umn-impish/kicad/README.md

# kicad files for the IMPISH piggyback

## BEFORE COMMITTING
- **REMOVE ANY BIG FILES (.ZIP, .STEP GENERATED FROM BOARD, ETC)**
    - Keeps clone times fast and repo size small

## HOW TO OPEN
- Install Kicad
- Open the project file
- ...
