umn-impish/kicad/analog-mezzanine/parts/5v regulators/TPS7A4901DGNT.step

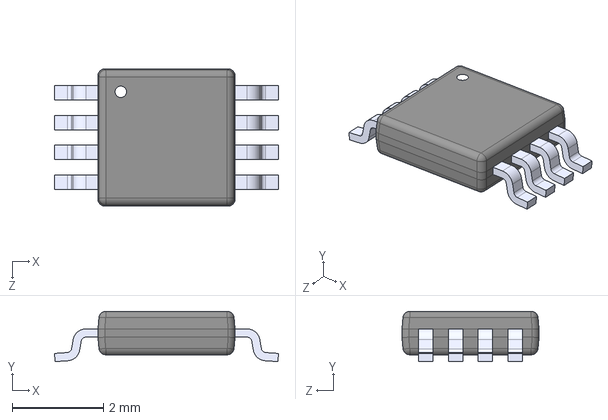
[picture p1: CAD file, 2025-06-12]
analog-mezzanine/parts/5v regulators/TPS7A4901DGNT.step
4.90 x 1.10 x 3.00 mm
