umn-impish/kicad/analog-mezzanine/parts/lowpass inductor/vls4015cx-h.step

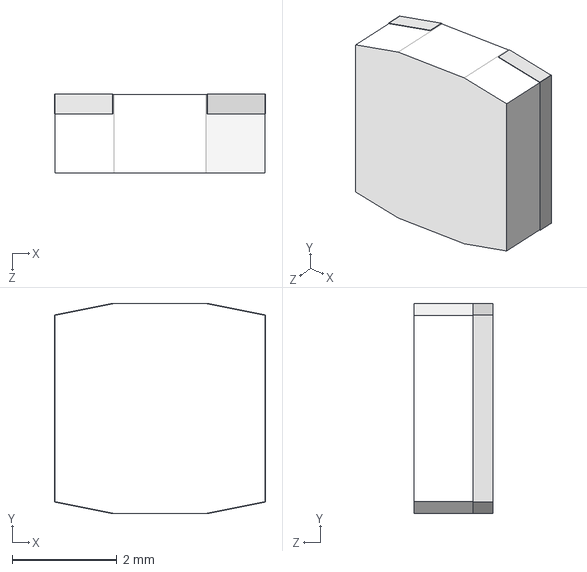
[picture p2: CAD file, 2025-06-12]
analog-mezzanine/parts/lowpass inductor/vls4015cx-h.step
4.02 x 4.01 x 1.50 mm
