umn-impish/kicad/bias-supply/components/42TM026-RC/42TM026-RC.stp

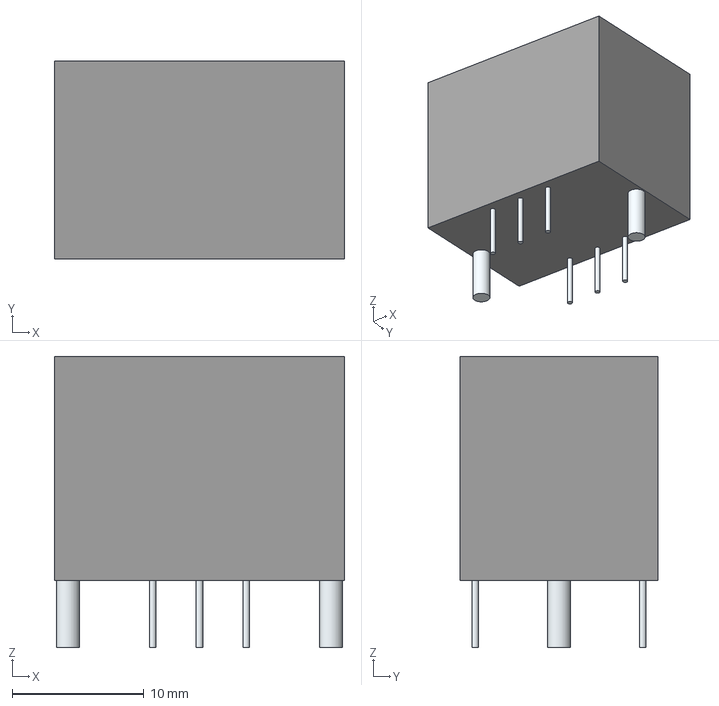
[picture p3: CAD file, 2024-10-08]
bias-supply/components/42TM026-RC/42TM026-RC.stp
22.0 x 15.0 x 22.1 mm
Leads
