umn-impish/kicad/bias-supply/components/AD5272BRMZ_20_RL7/AD5272BRMZ_20_RL7.stp

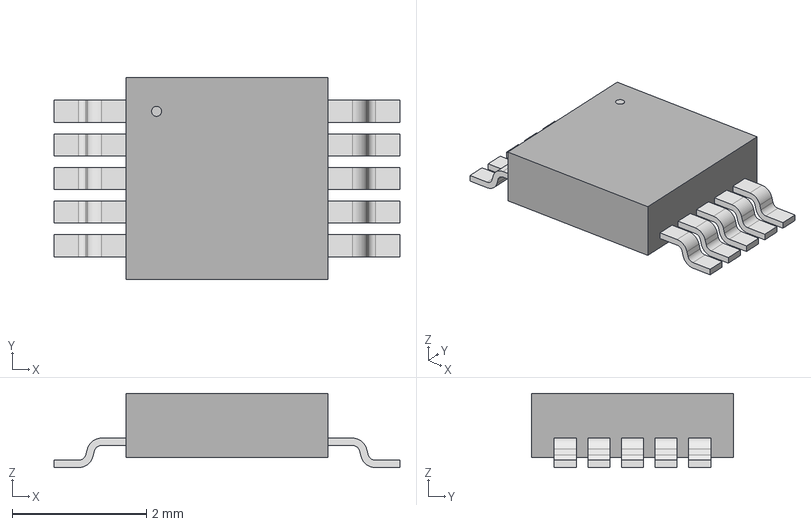
[picture p4: CAD file, 2025-06-12]
bias-supply/components/AD5272BRMZ_20_RL7/AD5272BRMZ_20_RL7.stp
5.15 x 3.00 x 1.10 mm
