umn-impish/kicad/bias-supply/components/AD5292BRUZ_100_RL7/AD5292BRUZ_100_RL7.stp

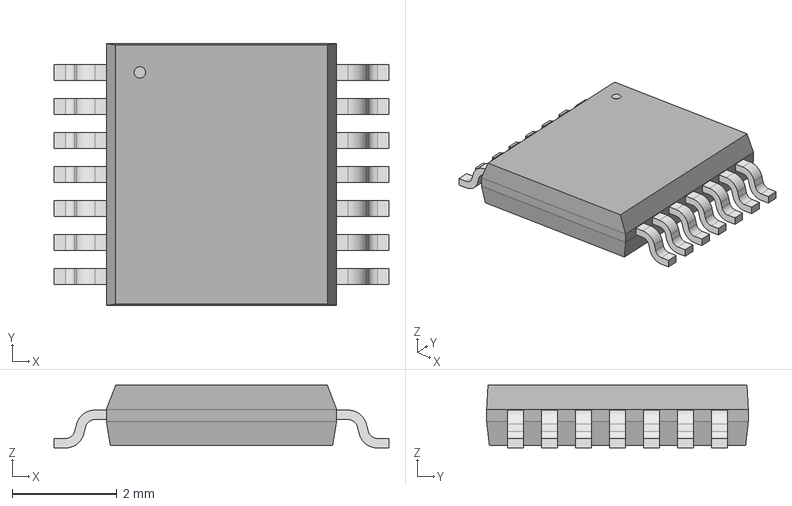
[picture p5: CAD file, 2025-06-12]
bias-supply/components/AD5292BRUZ_100_RL7/AD5292BRUZ_100_RL7.stp
6.40 x 5.00 x 1.20 mm
