umn-impish/kicad/bias-supply/components/ADP7142ARDZ-R7/SOIC8_ADP7142ARDZ-R7_ADI.step

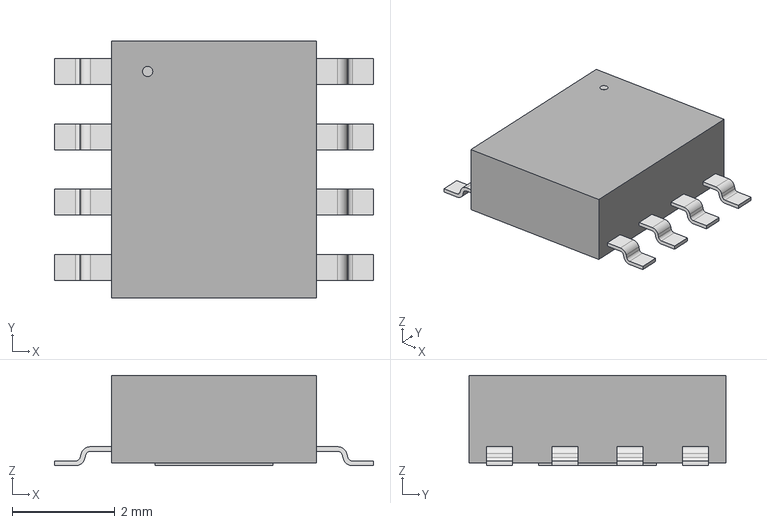
[picture p6: CAD file, 2024-10-08]
bias-supply/components/ADP7142ARDZ-R7/SOIC8_ADP7142ARDZ-R7_ADI.step
6.20 x 5.00 x 1.75 mm
