umn-impish/kicad/bias-supply/components/ADUM1253ASA/ADUM1253ASA.stp

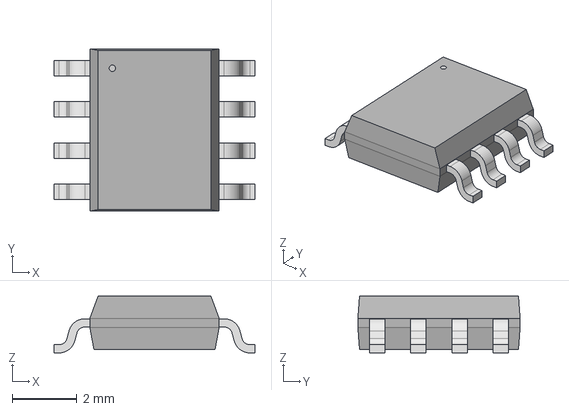
[picture p7: CAD file, 2025-06-12]
bias-supply/components/ADUM1253ASA/ADUM1253ASA.stp
6.20 x 5.00 x 1.75 mm
