umn-impish/kicad/bias-supply/components/BNX022_01L/BNX022-01L.stp

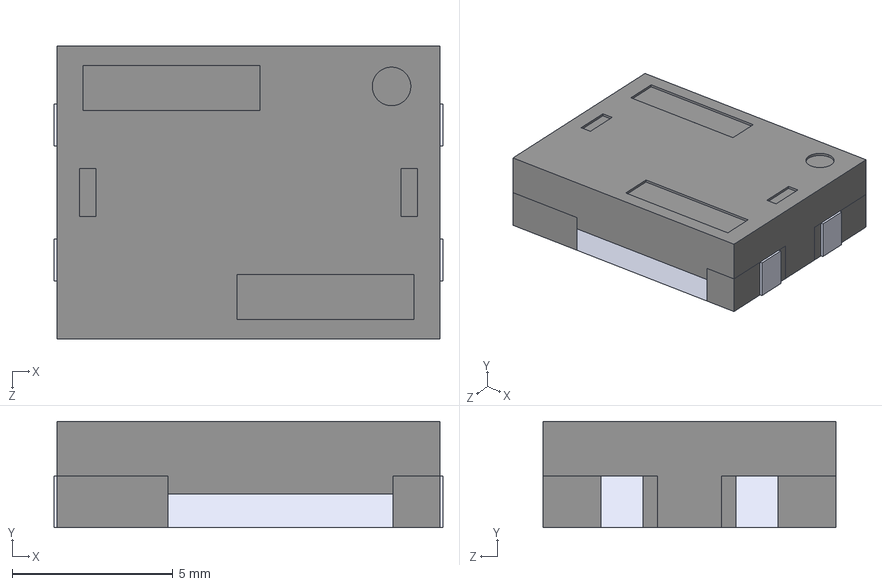
[picture p8: CAD file, 2024-10-08]
bias-supply/components/BNX022_01L/BNX022-01L.stp
12.1 x 3.30 x 9.10 mm
