umn-impish/kicad/bias-supply/components/DTDG14GPT100/DTDG14GPT100.stp

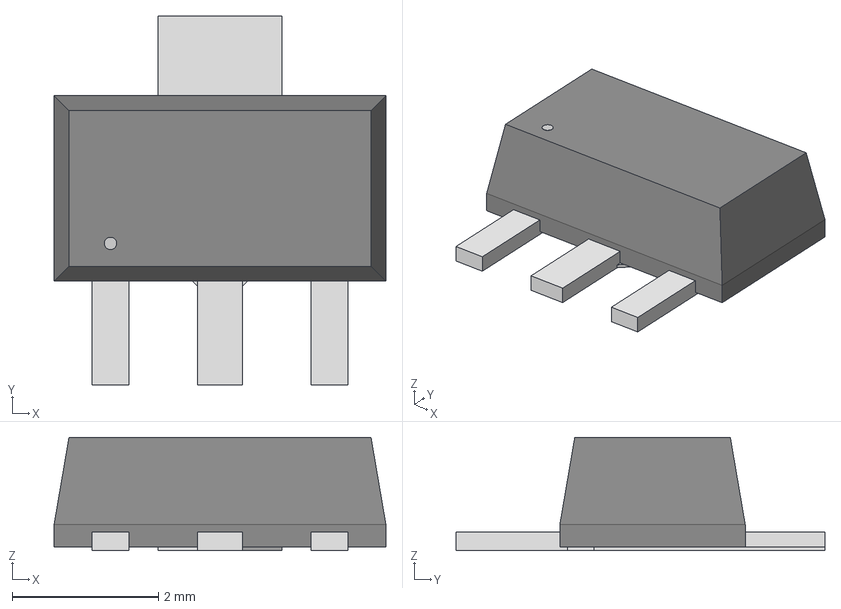
[picture p9: CAD file, 2024-10-08]
bias-supply/components/DTDG14GPT100/DTDG14GPT100.stp
4.55 x 5.05 x 1.55 mm
