umn-impish/kicad/bias-supply/components/F0603G0R02FNTR/F0603G0R02FNTR.stp

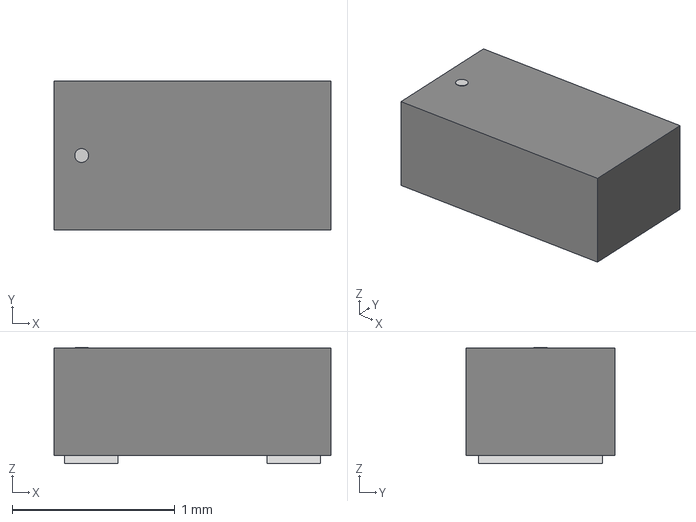
[picture p10: CAD file, 2026-04-10]
bias-supply/components/F0603G0R02FNTR/F0603G0R02FNTR.stp
1.70 x 0.914 x 0.714 mm
