umn-impish/kicad/bias-supply/components/KDZVTR36B/DIO_KDZLVTF100_ROM.step

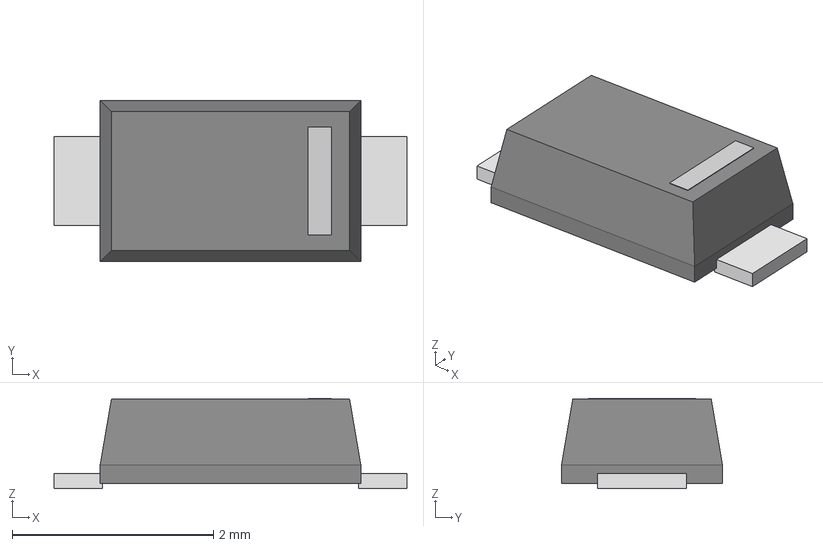
[picture p11: CAD file, 2024-10-08]
bias-supply/components/KDZVTR36B/DIO_KDZLVTF100_ROM.step
3.51 x 1.60 x 0.895 mm
