umn-impish/kicad/bias-supply/components/KMB22S/KMB22S.stp

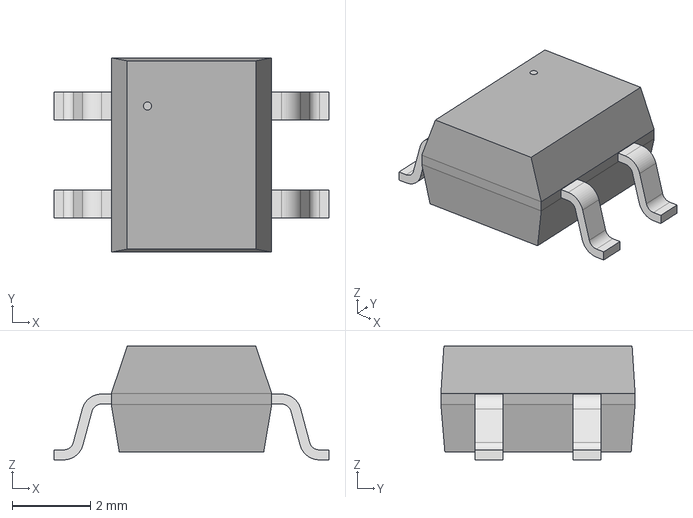
[picture p12: CAD file, 2024-10-08]
bias-supply/components/KMB22S/KMB22S.stp
7.01 x 4.95 x 2.90 mm
