umn-impish/kicad/bias-supply/components/LT3013MPFE_PBF/LT3013MPFE_PBF.stp

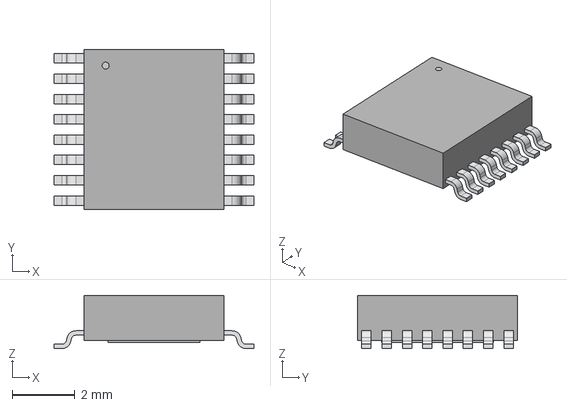
[picture p13: CAD file, 2025-06-12]
bias-supply/components/LT3013MPFE_PBF/LT3013MPFE_PBF.stp
6.40 x 5.11 x 1.70 mm
