umn-impish/kicad/bias-supply/components/MIC5281_3_3YMME_TR/MIC5281_3_3YMME_TR.stp

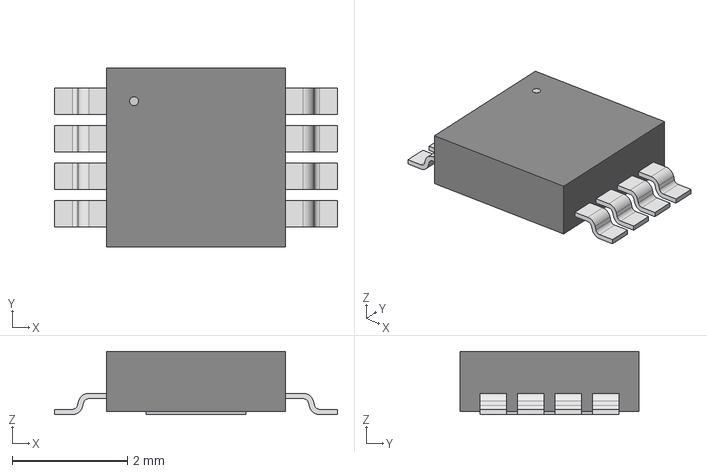
[picture p14: CAD file, 2025-06-12]
bias-supply/components/MIC5281_3_3YMME_TR/MIC5281_3_3YMME_TR.stp
4.90 x 3.10 x 1.09 mm
