umn-impish/kicad/bias-supply/components/MSD1278/MSD1278.stp

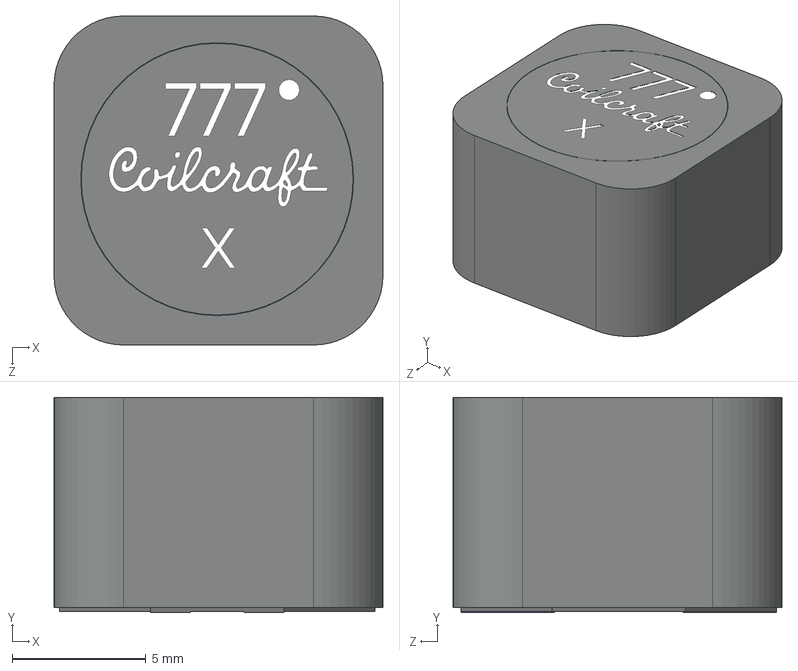
[picture p15: CAD file, 2024-10-08]
bias-supply/components/MSD1278/MSD1278.stp
12.3 x 8.05 x 12.3 mm
