umn-impish/kicad/bias-supply/components/Samtec-SMA/SMA-J-P-X-ST-TH1.stp

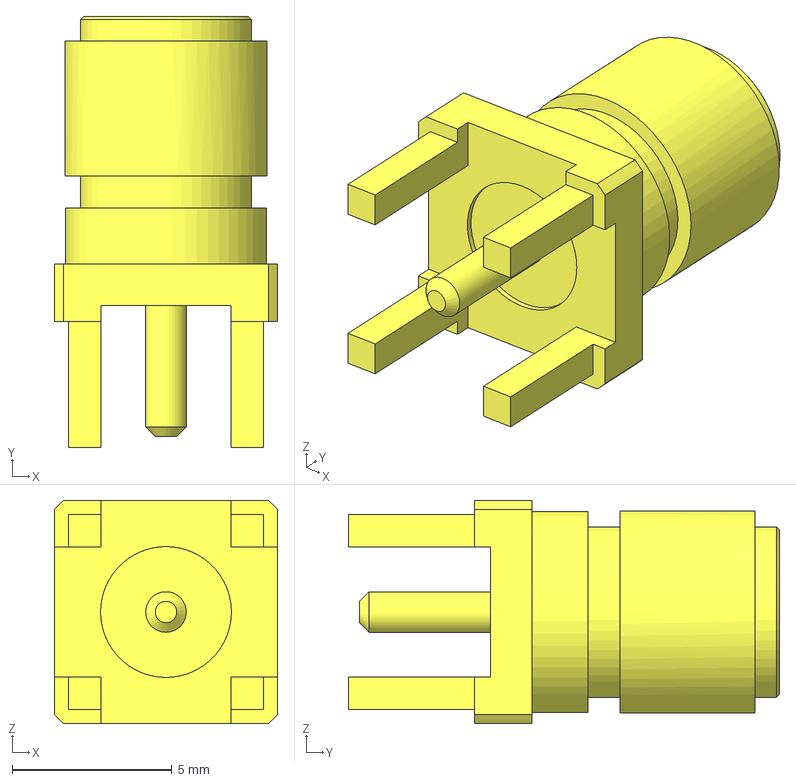
[picture p16: CAD file, 2024-10-08]
bias-supply/components/Samtec-SMA/SMA-J-P-X-ST-TH1.stp
7.00 x 13.5 x 7.00 mm
