umn-impish/kicad/bias-supply/components/TCA0372BDWR2G/TCA0372BDWR2G.stp

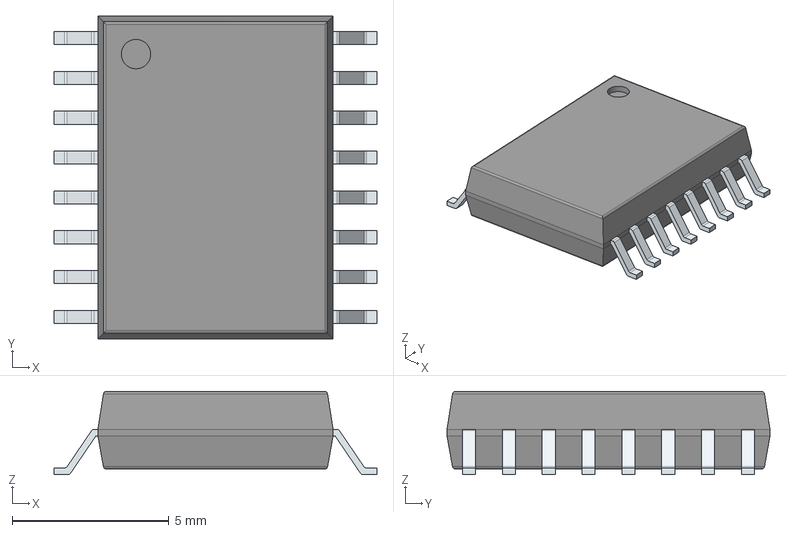
[picture p17: CAD file, 2024-10-08]
bias-supply/components/TCA0372BDWR2G/TCA0372BDWR2G.stp
10.3 x 10.3 x 2.65 mm
PinsArrayLR
