umn-impish/kicad/emmc-tester/emmc_100ball.step

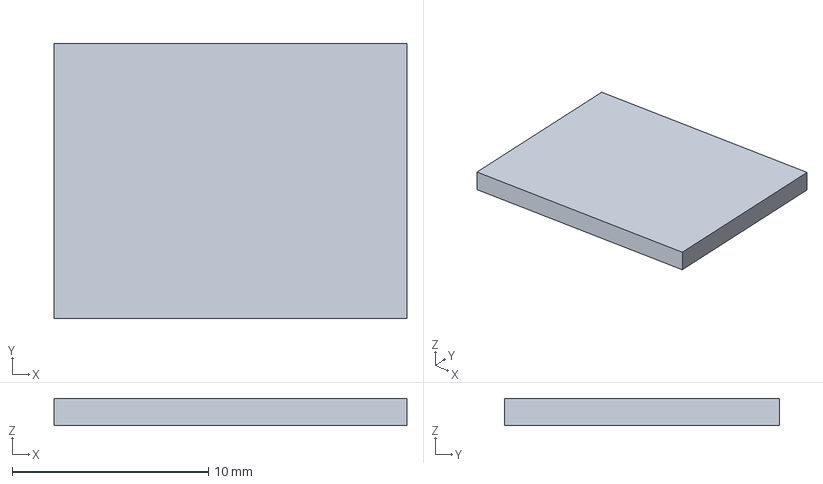
[picture p18: CAD file, 2025-07-15]
emmc-tester/emmc_100ball.step
18.0 x 14.0 x 1.40 mm
