umn-impish/kicad/lvps-swri/3D Models/T495X106K050ATE300.step

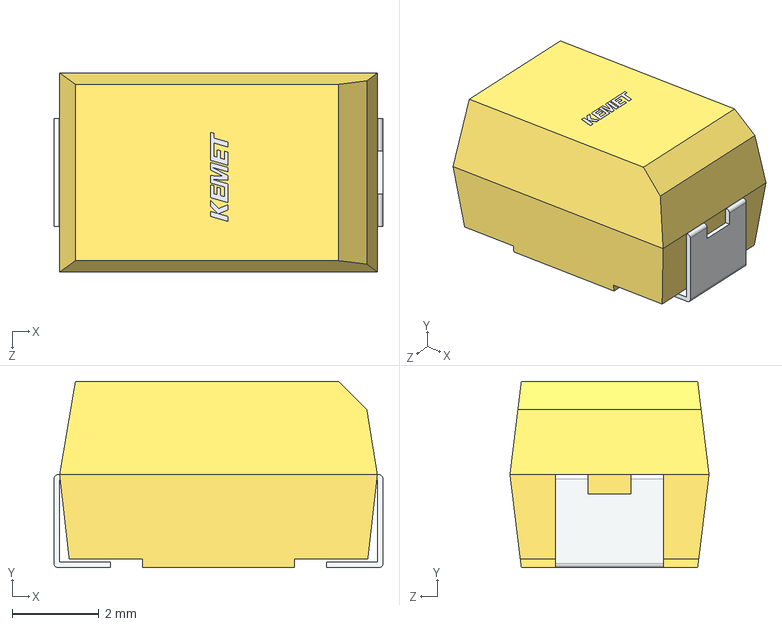
[picture p19: CAD file, 2025-06-26]
lvps-swri/3D Models/T495X106K050ATE300.step
7.60 x 4.31 x 4.60 mm
