umn-impish/kicad/lvps-toggles-adapter/lvps-toggles-adapter.step

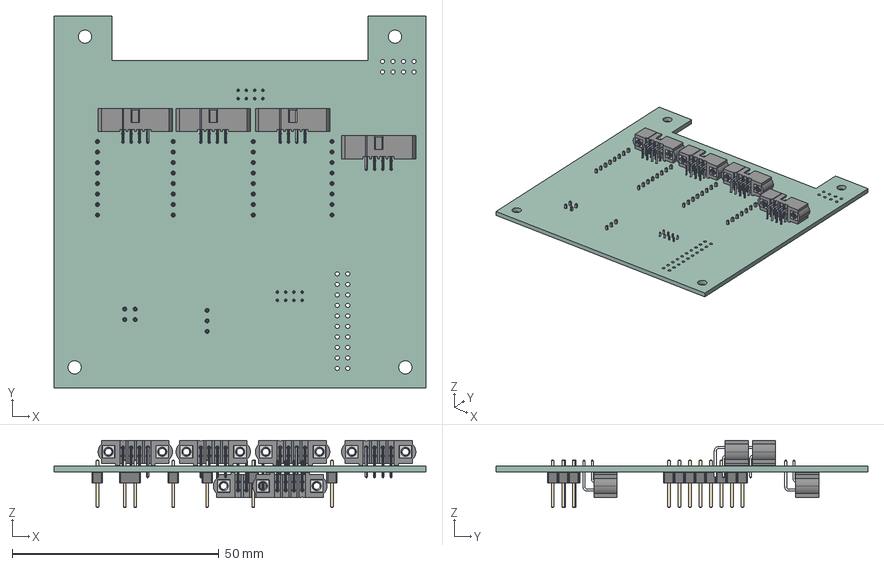
[picture p20: CAD file, 2025-09-08]
lvps-toggles-adapter/lvps-toggles-adapter.step
90.0 x 90.0 x 16.3 mm
PinHeader_1x08_P2.54mm_Vertical x 4
PinHeader_2x02_P2.54mm_Vertical
PinHeader_1x03_P2.54mm_Vertical
lvps-toggles-adapter_PCB
