umn-impish/kicad/lvps-toggles-adapter/parts/plastic ethernet/RJHSE50800104.step

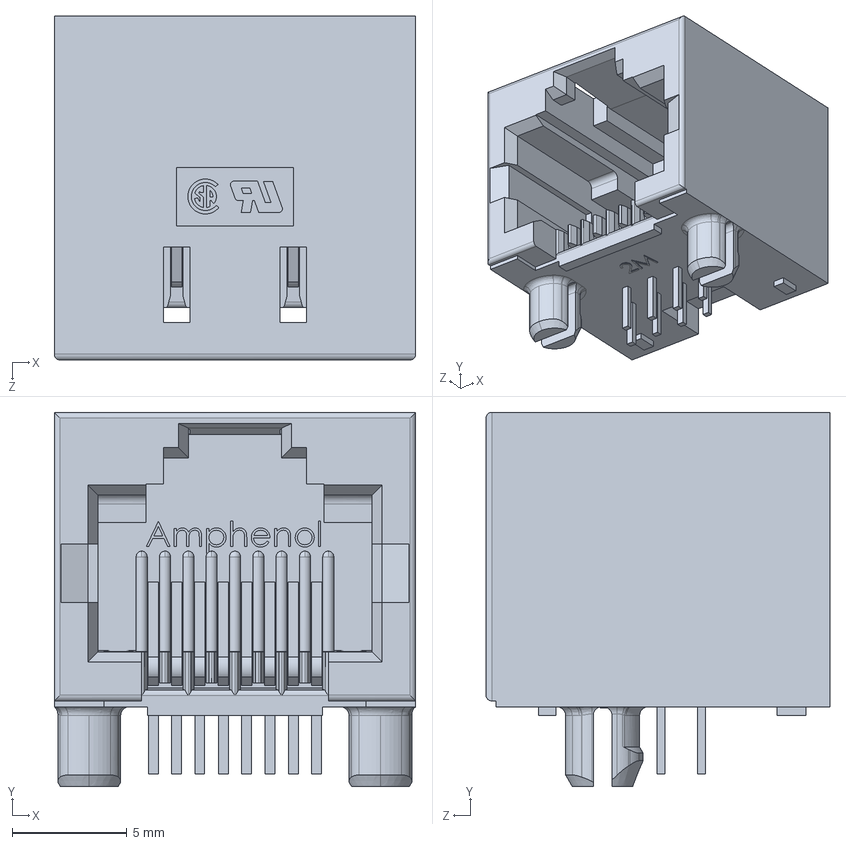
[picture p21: CAD file, 2025-09-08]
lvps-toggles-adapter/parts/plastic ethernet/RJHSE50800104.step
15.7 x 16.3 x 15.0 mm
