umn-impish/kicad/lvps-toggles-swri/3D Models/MTSW-117-10-L-D-070.stp

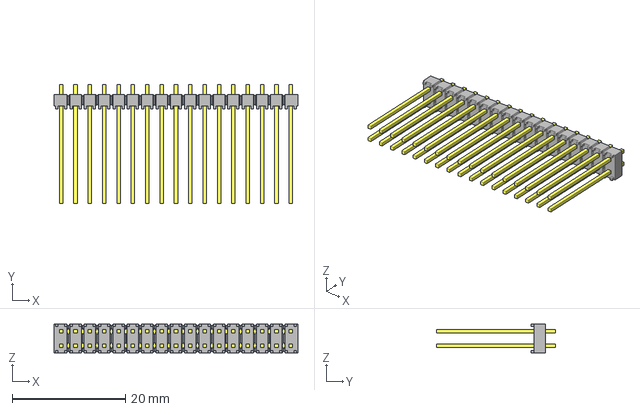
[picture p22: CAD file, 2025-09-08]
lvps-toggles-swri/3D Models/MTSW-117-10-L-D-070.stp
43.2 x 21.1 x 5.08 mm
MTSW-117-10-L-D-070_body
MTSW-117-10-D-070
