umn-impish/kicad/onsemi-double-coax-no-amp/coax/SMP-PF-P-HG-ST-TH2.step

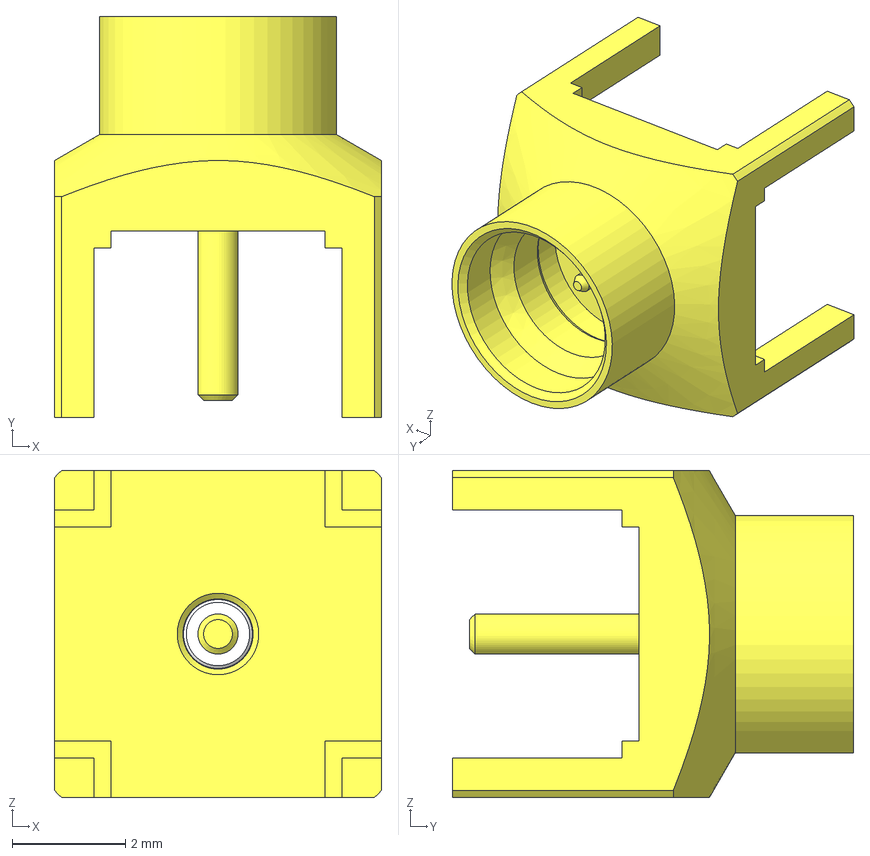
[picture p23: CAD file, 2024-10-10]
onsemi-double-coax-no-amp/coax/SMP-PF-P-HG-ST-TH2.step
5.78 x 7.09 x 5.78 mm
SMP-PF-P-HG-ST-TH2_p
SMP-PF-P-HG-ST-TH2_i
SMP-PF-P-HG-ST-TH2_s
