umn-impish/kicad/onsemi-double-coax-no-amp/DF13-3P-1.25DSA.stp

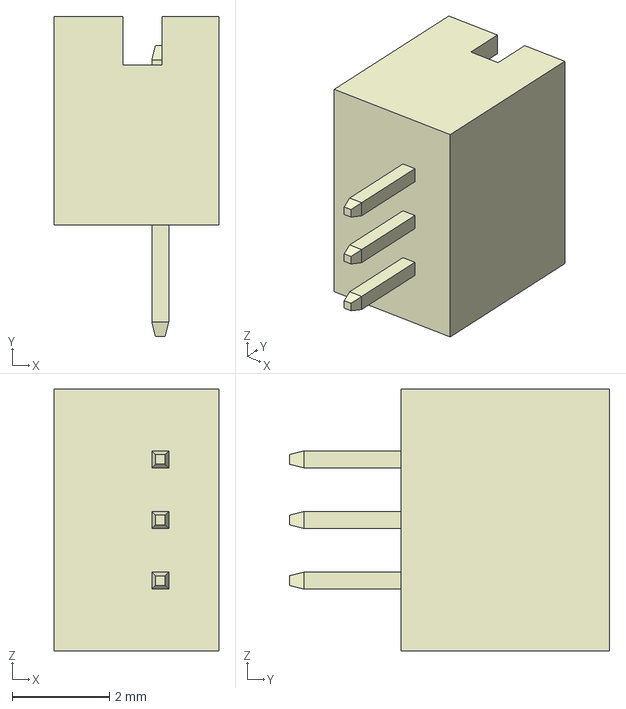
[picture p24: CAD file, 2024-10-10]
onsemi-double-coax-no-amp/DF13-3P-1.25DSA.stp
3.40 x 6.60 x 5.40 mm
