umn-impish/kicad/peak-holder/components/3214W_1_504E/3214W-1-504E.step

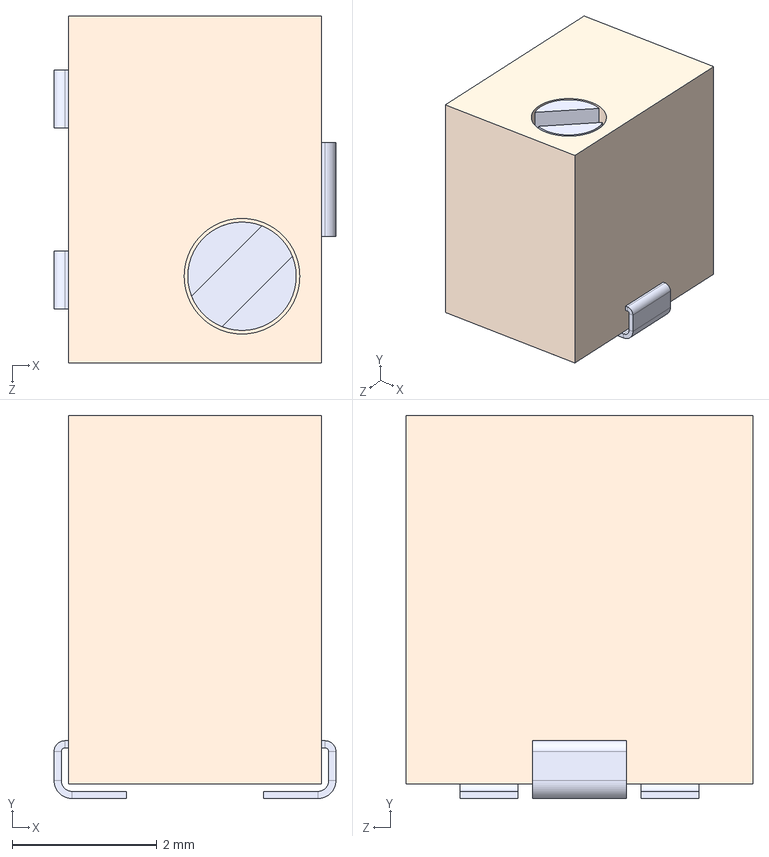
[picture p25: CAD file, 2024-10-10]
peak-holder/components/3214W_1_504E/3214W-1-504E.step
3.90 x 5.30 x 4.80 mm
