umn-impish/kicad/peak-holder/components/74LVCE1G04SE-7/74LVCE1G04SE-7.step

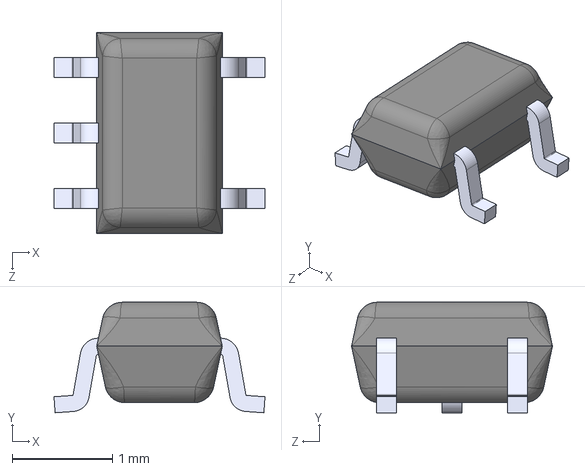
[picture p26: CAD file, 2024-10-10]
peak-holder/components/74LVCE1G04SE-7/74LVCE1G04SE-7.step
2.10 x 1.10 x 2.00 mm
