umn-impish/kicad/peak-holder/components/DS1100Z-20+/21-0041B_8_MXM.step

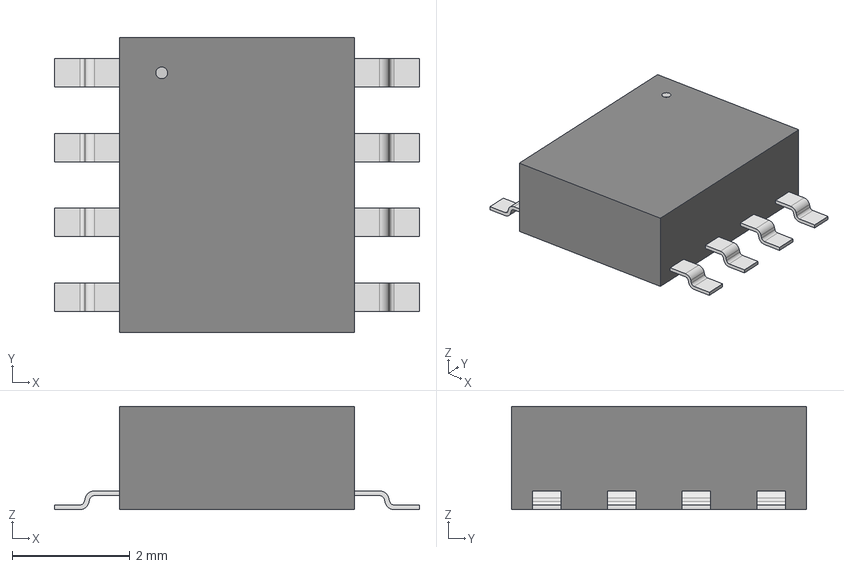
[picture p27: CAD file, 2024-10-10]
peak-holder/components/DS1100Z-20+/21-0041B_8_MXM.step
6.20 x 5.00 x 1.75 mm
