umn-impish/kicad/peak-holder/components/hold-cap/FKP2_04_5WX06_0HX07_2L_WIM.step

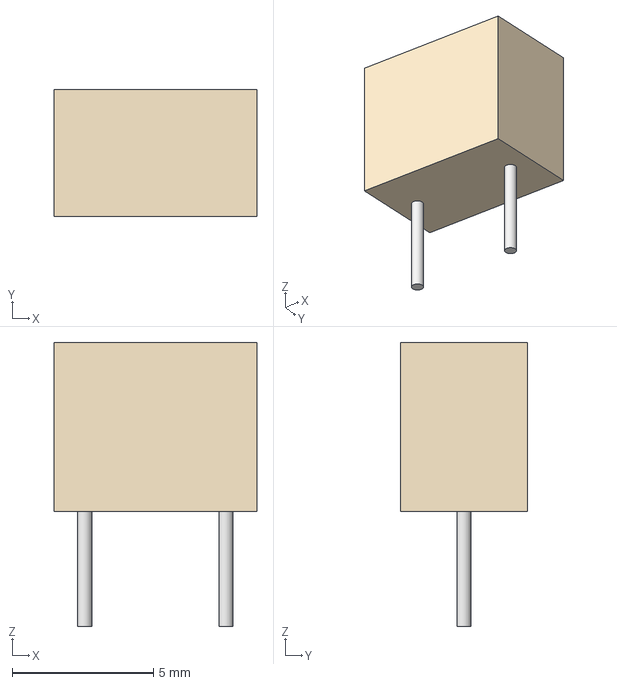
[picture p28: CAD file, 2024-10-10]
peak-holder/components/hold-cap/FKP2_04_5WX06_0HX07_2L_WIM.step
7.19 x 4.50 x 10.1 mm
