umn-impish/kicad/peak-holder/components/NC7ST04P5X/NC7ST04P5X.step

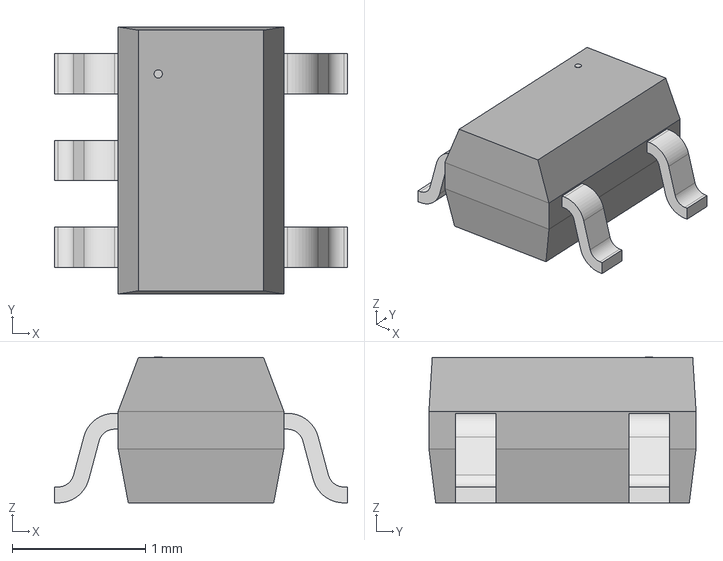
[picture p29: CAD file, 2024-10-10]
peak-holder/components/NC7ST04P5X/NC7ST04P5X.step
2.20 x 2.01 x 1.09 mm
