umn-impish/kicad/peak-holder/components/OPA615/DGS0010A.stp

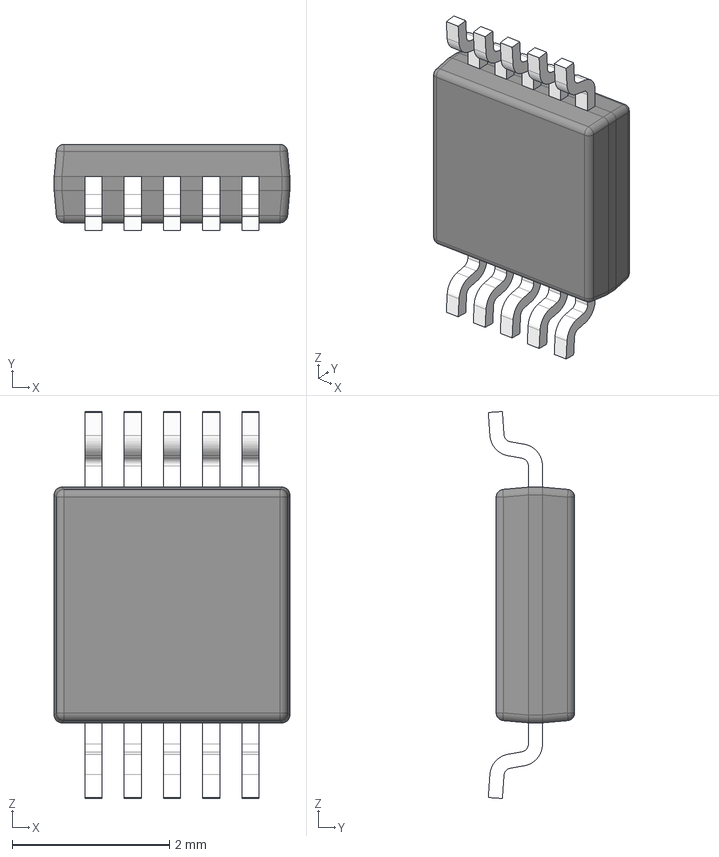
[picture p30: CAD file, 2024-10-08]
peak-holder/components/OPA615/DGS0010A.stp
3.00 x 1.10 x 4.93 mm
BODY-SO
LEAD-SO x 10
PIN1-ID
