umn-impish/kicad/peak-holder/components/PWB-1-BL/Coilcraft-PWB Series.STEP

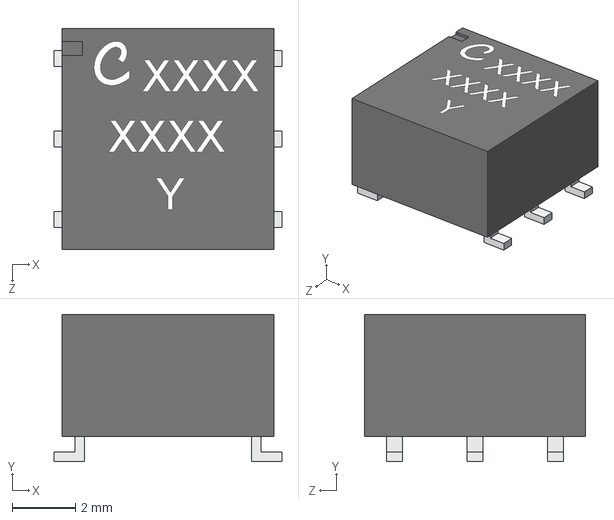
[picture p31: CAD file, 2024-10-10]
peak-holder/components/PWB-1-BL/Coilcraft-PWB Series.STEP
7.20 x 4.65 x 6.97 mm
