umn-impish/kicad/peak-holder/components/SN74LVC1G123DCUR/SN74LVC1G123DCUR.step

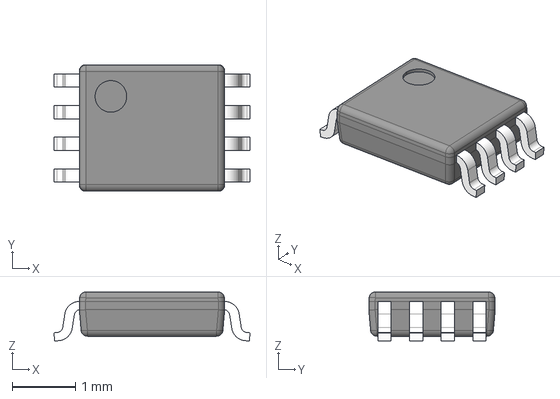
[picture p32: CAD file, 2024-10-10]
peak-holder/components/SN74LVC1G123DCUR/SN74LVC1G123DCUR.step
3.10 x 2.00 x 0.775 mm
BODY-VSSOP
LEAD-VSSOP x 8
