umn-impish/kicad/peak-holder/components/TLV3601DBVR/TLV3601.step

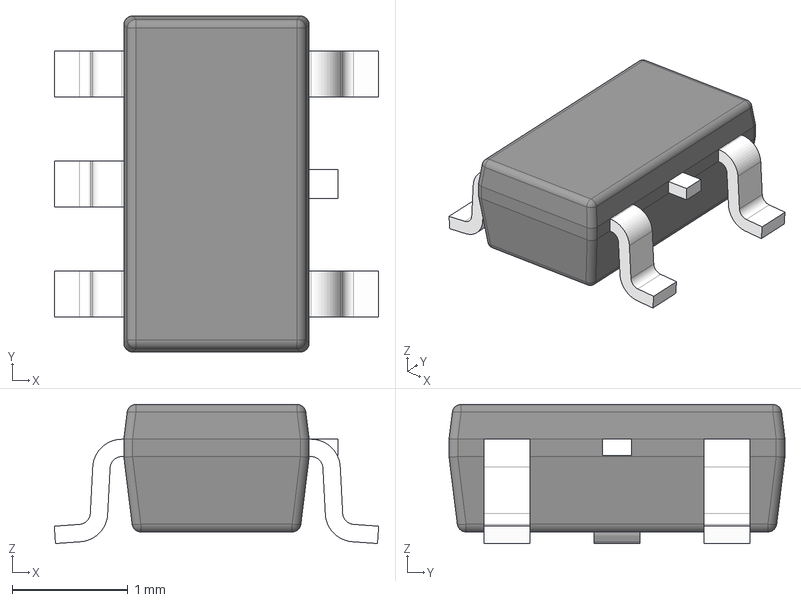
[picture p33: CAD file, 2024-10-10]
peak-holder/components/TLV3601DBVR/TLV3601.step
2.80 x 2.90 x 1.20 mm
BODY-SOT
LEAD-SOT x 5
LEAD-DUMMY
