umn-impish/kicad/sipm-carrier-flight/components/adp7185/CP-8-27_ADI.step

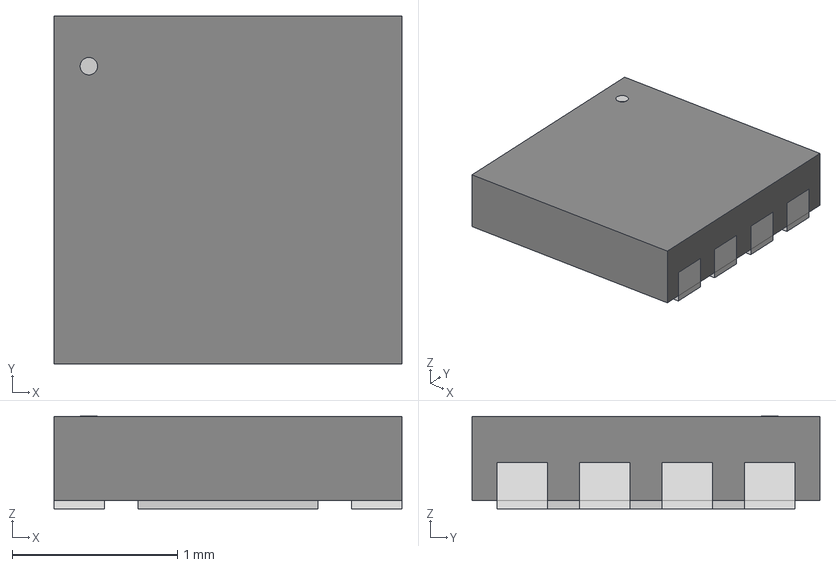
[picture p34: CAD file, 2024-10-10]
sipm-carrier-flight/components/adp7185/CP-8-27_ADI.step
2.11 x 2.11 x 0.561 mm
