umn-impish/kicad/sipm-carrier-flight/components/broadcom-sipms/AFBR-S4N66P014M.stp

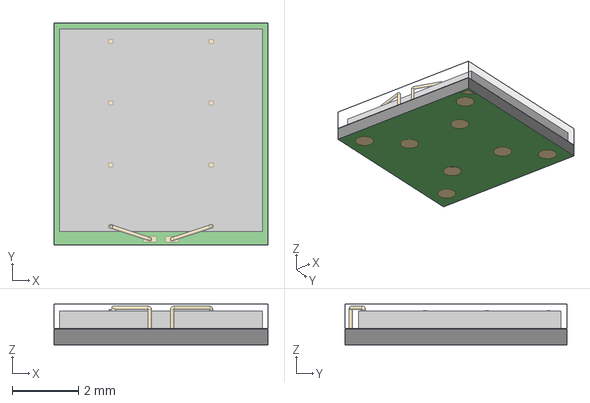
[picture p35: CAD file, 2025-04-07]
sipm-carrier-flight/components/broadcom-sipms/AFBR-S4N66P014M.stp
6.48 x 6.71 x 1.23 mm
