umn-impish/kicad/sipm-carrier-flight/components/BUF602/D0008A.stp

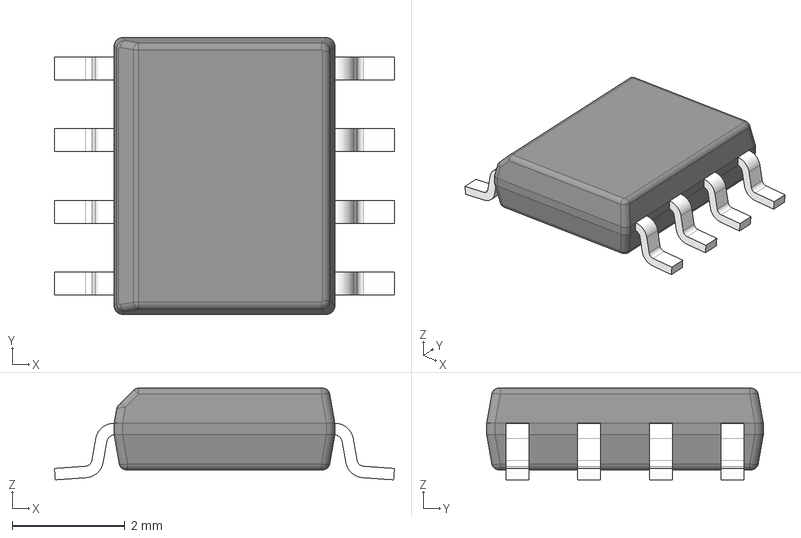
[picture p36: CAD file, 2024-10-10]
sipm-carrier-flight/components/BUF602/D0008A.stp
6.02 x 4.90 x 1.63 mm
BODY-SO
LEAD-D0008A x 8
