umn-impish/kicad/sipm-carrier-flight/components/CONSMA020.062-G/CONSMA020.062-G.step

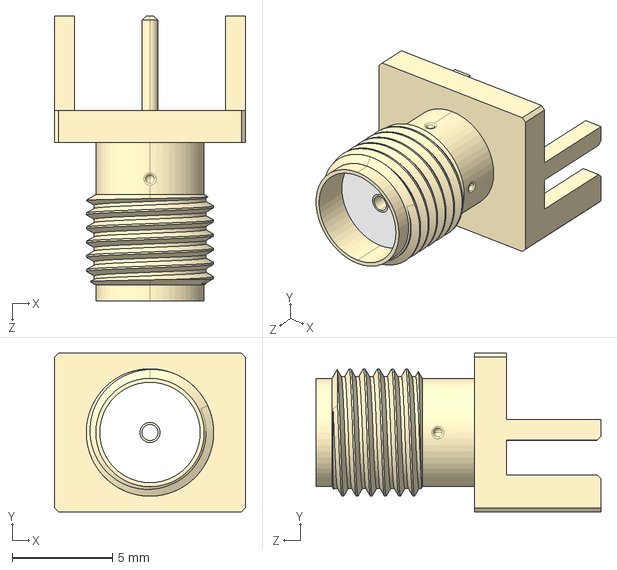
[picture p37: CAD file, 2024-10-24]
sipm-carrier-flight/components/CONSMA020.062-G/CONSMA020.062-G.step
9.52 x 7.92 x 14.2 mm
