umn-impish/kicad/sipm-carrier-flight/components/EMPCB.SMAFSTJ.B.HT/EMPCB.SMAFSTJ.B.HT.step

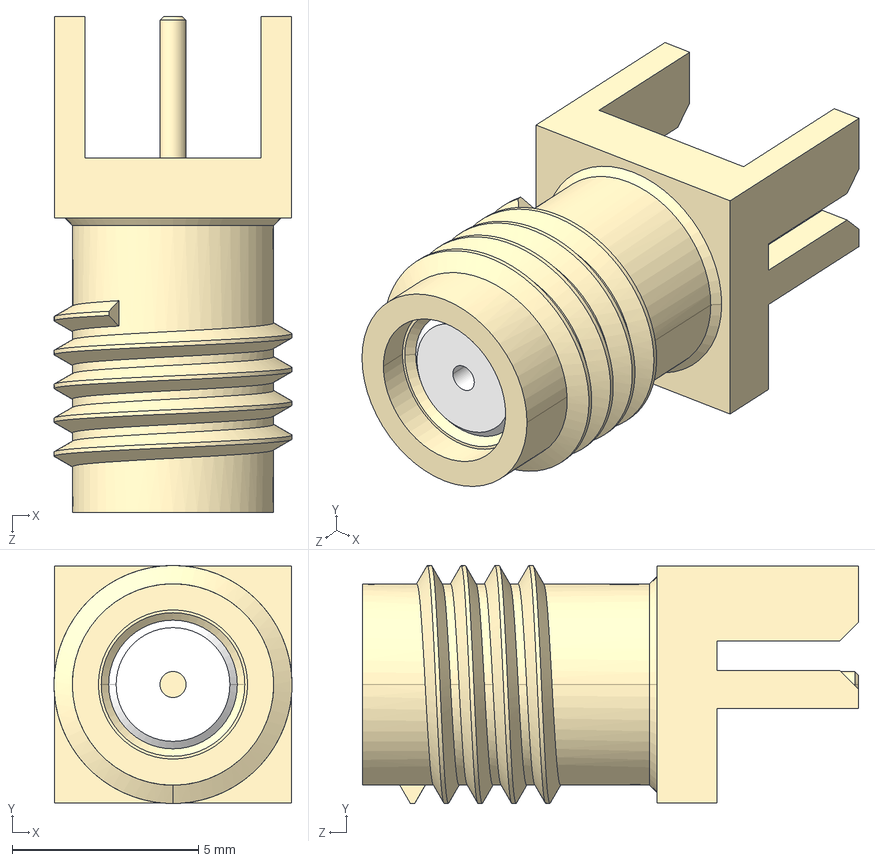
[picture p38: CAD file, 2024-10-10]
sipm-carrier-flight/components/EMPCB.SMAFSTJ.B.HT/EMPCB.SMAFSTJ.B.HT.step
6.38 x 6.38 x 13.3 mm
