umn-impish/kicad/sipm-carrier-flight/components/ltc6268/LTC6268HS8-10_PBF.step

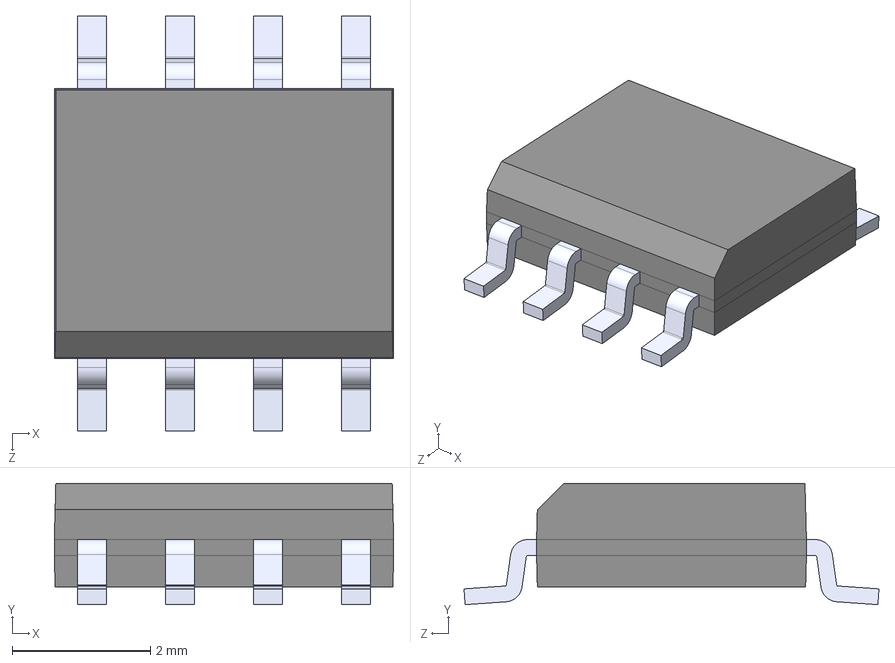
[picture p39: CAD file, 2024-10-10]
sipm-carrier-flight/components/ltc6268/LTC6268HS8-10_PBF.step
4.90 x 1.75 x 5.99 mm
