umn-impish/kicad/sipm-carrier-flight/components/onsemi-cseries-6mm2/MICROFC-60035-SMT-TR1.step

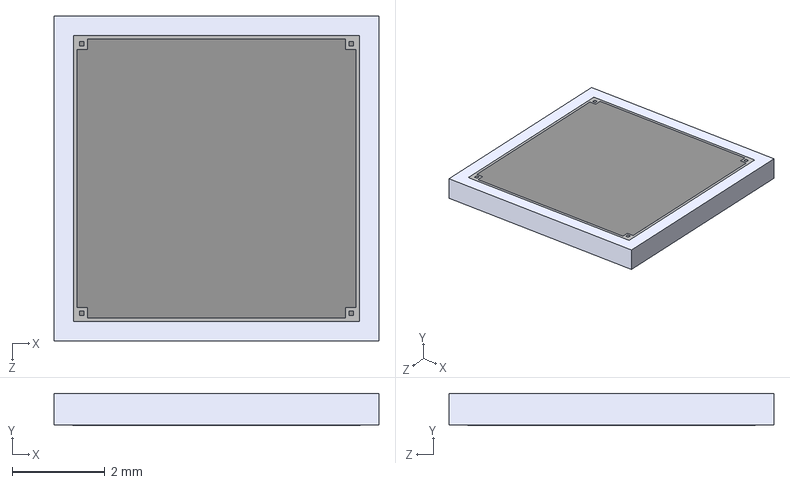
[picture p40: CAD file, 2024-10-10]
sipm-carrier-flight/components/onsemi-cseries-6mm2/MICROFC-60035-SMT-TR1.step
7.00 x 0.7 x 7.00 mm
