umn-impish/kicad/sipm-carrier-flight/components/three-winding choke/Download_STP_744253101_rev1.stp

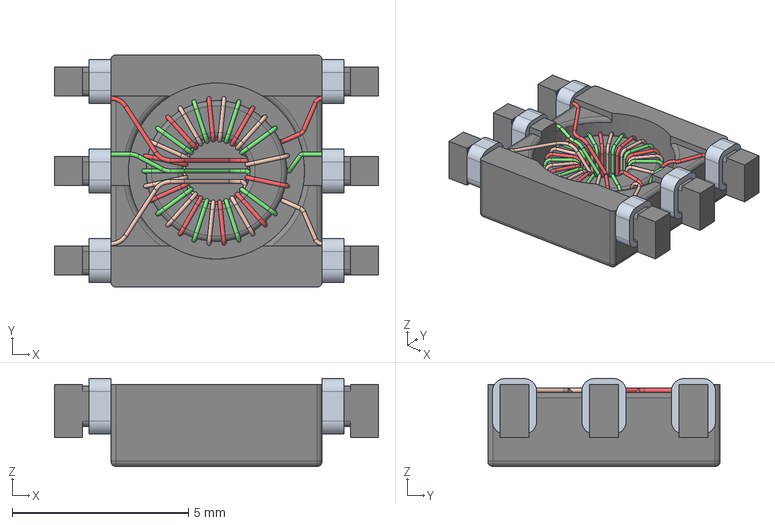
[picture p41: CAD file, 2025-06-12]
sipm-carrier-flight/components/three-winding choke/Download_STP_744253101_rev1.stp
9.20 x 6.60 x 2.50 mm
