umn-impish/kicad/sipm-carrier-flight/components/wurth-865080340001/WCAP-ASLI_4X5.5.step

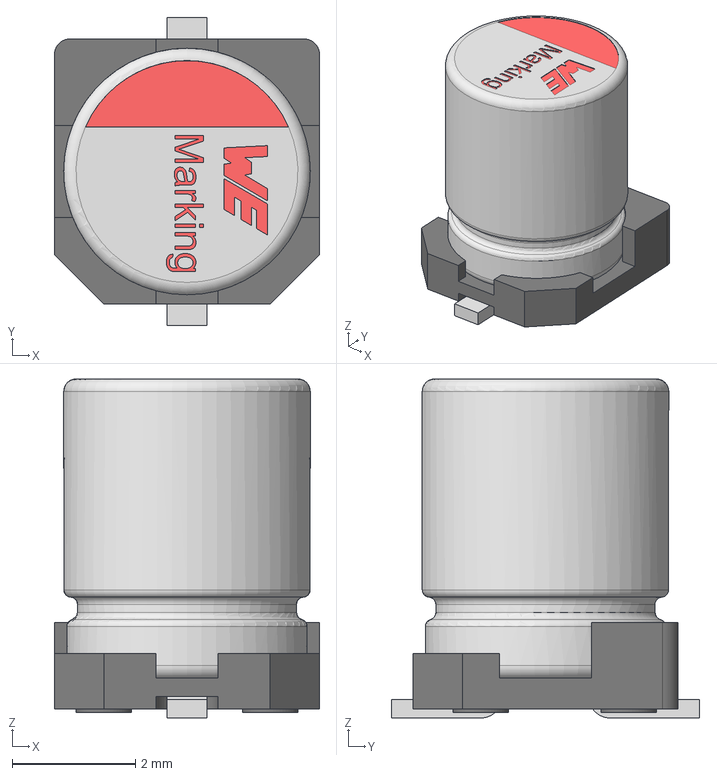
[picture p42: CAD file, 2024-10-10]
sipm-carrier-flight/components/wurth-865080340001/WCAP-ASLI_4X5.5.step
4.30 x 5.00 x 5.50 mm
capicitor_4x5.5x1
Base_Φ4Capacitor
