umn-impish/kicad/tia-csp-test-board/ad8001/R_8_ADI.step

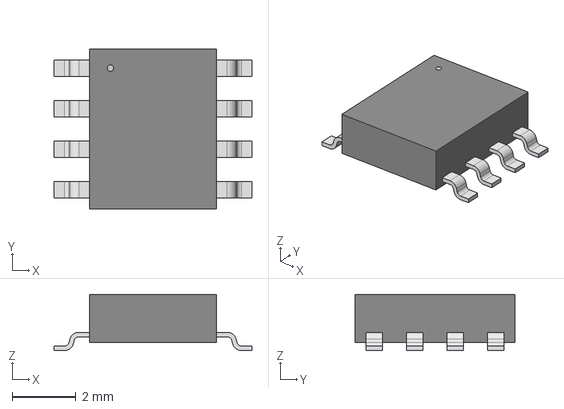
[picture p43: CAD file, 2024-10-10]
tia-csp-test-board/ad8001/R_8_ADI.step
6.20 x 5.00 x 1.75 mm
