umn-impish/kicad/tia-csp-test-board/lt1763/DFN-12_DE_LIT.step

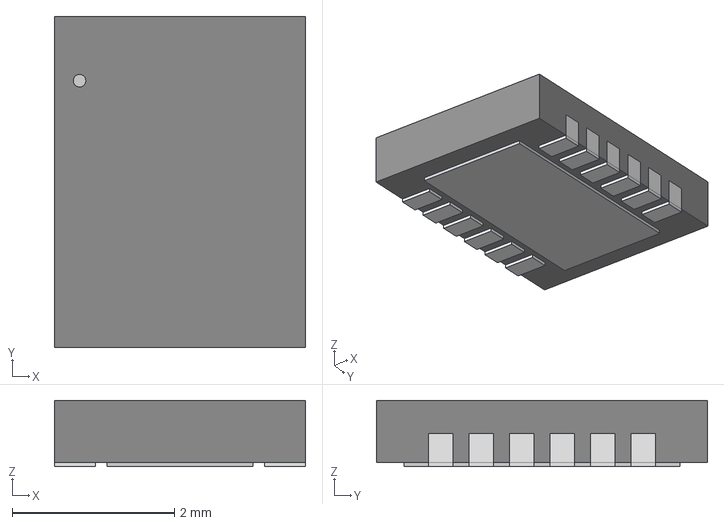
[picture p44: CAD file, 2024-10-10]
tia-csp-test-board/lt1763/DFN-12_DE_LIT.step
3.10 x 4.09 x 0.815 mm
