umn-impish/kicad/analog-mezzanine/parts/5v regulators/DGN0008D.stp

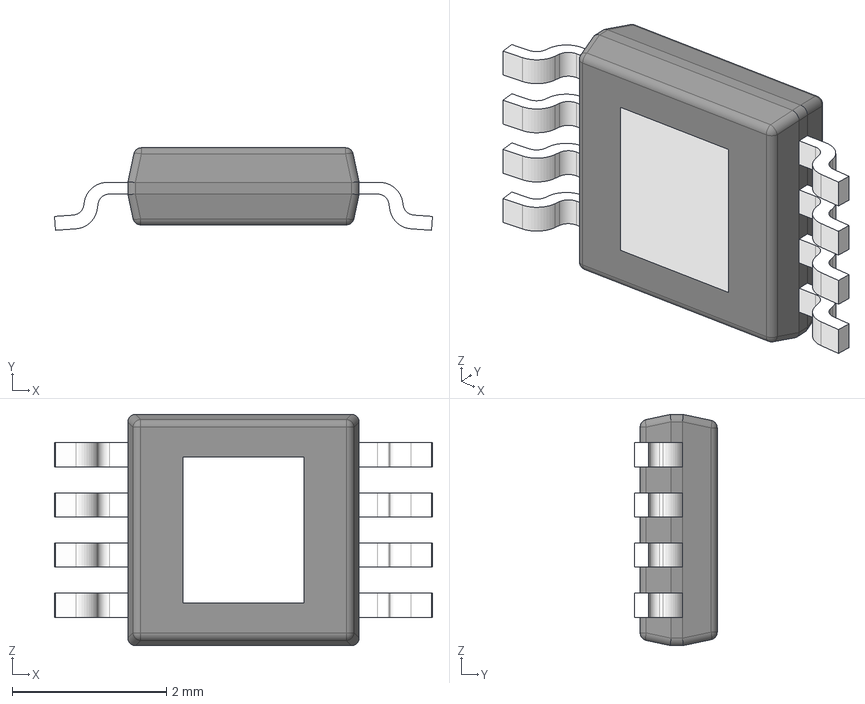
[picture p45: CAD file, 2025-06-12]
analog-mezzanine/parts/5v regulators/DGN0008D.stp
4.90 x 1.07 x 3.00 mm
BODY-HVSSOP
LEAD-HVSSOP x 8
PIN1_HVSSOP
DAP_HVSSOP
