umn-impish/kicad/lvps-swri/3D Models/CR_10S-M3I_VIS.step

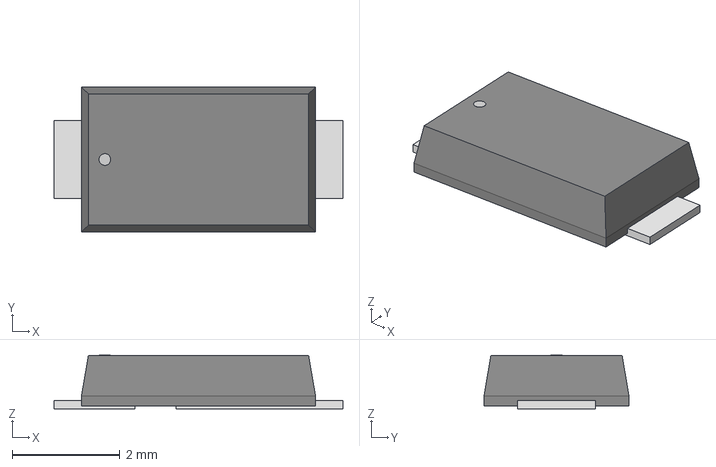
[picture p46: CAD file, 2025-06-26]
lvps-swri/3D Models/CR_10S-M3I_VIS.step
5.36 x 2.69 x 0.993 mm
