umn-impish/kicad/lvps-toggles-swri/3D Models/MTSW-117-08-L-D-100.stp

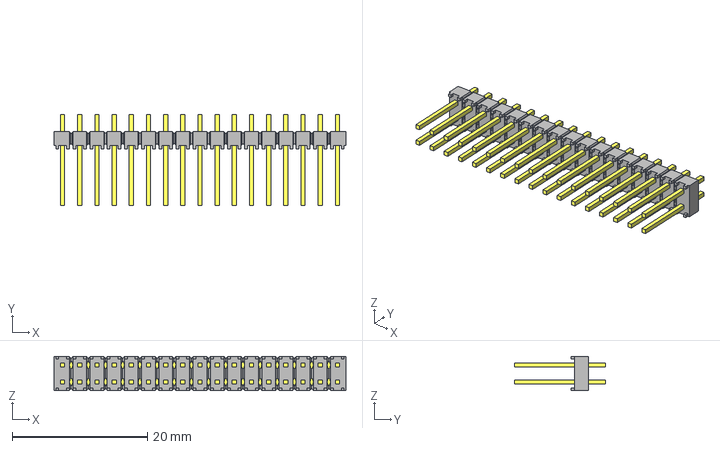
[picture p47: CAD file, 2025-09-08]
lvps-toggles-swri/3D Models/MTSW-117-08-L-D-100.stp
43.2 x 13.5 x 5.08 mm
MTSW-117-08-L-D-100_body
MTSW-117-08-D-100
