umn-impish/kicad/fc-board/models/LTC2983ILX-PBF.stp

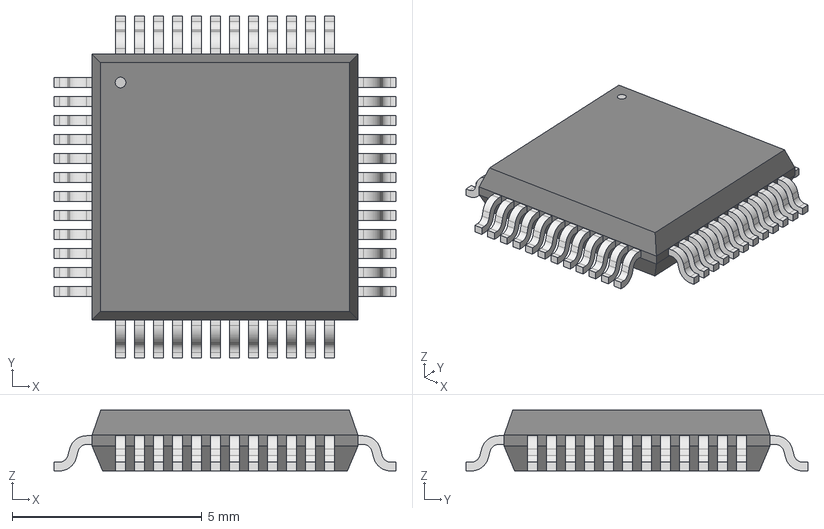
[picture p48: CAD file, 2025-11-19]
fc-board/models/LTC2983ILX-PBF.stp
9.00 x 9.00 x 1.60 mm
