umn-impish/kicad/lvps-swri/3D Models/DE2B3SA101KN3AY02F.step

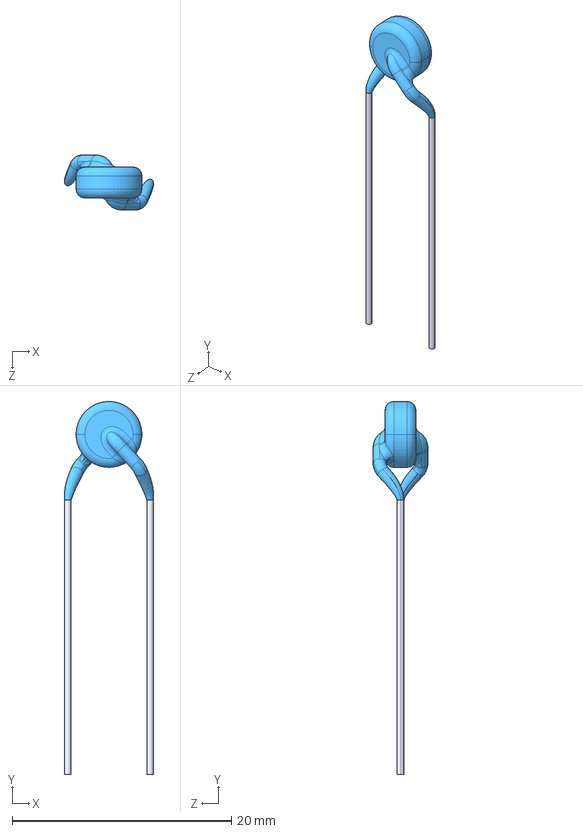
[picture p49: CAD file, 2025-06-26]
lvps-swri/3D Models/DE2B3SA101KN3AY02F.step
8.14 x 34.0 x 5.00 mm
