umn-impish/kicad/lvps-toggles-swri/3D Models/MTSW-117-09-L-D-100.stp

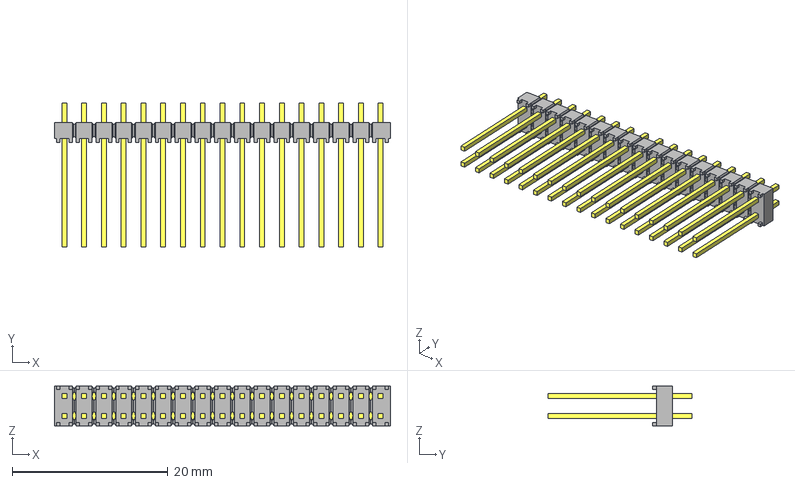
[picture p50: CAD file, 2025-09-08]
lvps-toggles-swri/3D Models/MTSW-117-09-L-D-100.stp
43.2 x 18.5 x 5.08 mm
MTSW-117-09-L-D-100_body
MTSW-117-09-D-100
