umn-impish/kicad/fc-board/models/VLS3012HBX-3R3M.stp

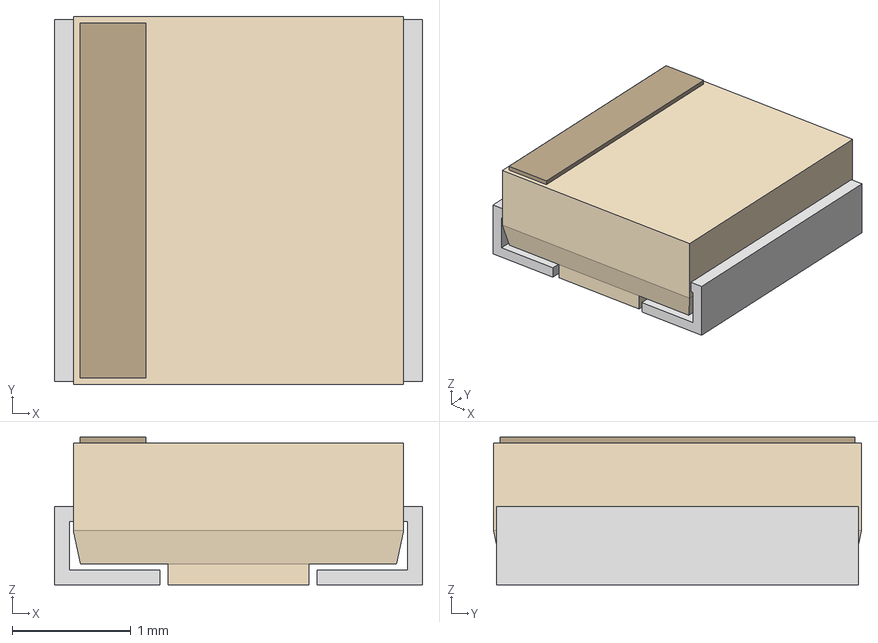
[picture p51: CAD file, 2025-11-19]
fc-board/models/VLS3012HBX-3R3M.stp
3.10 x 3.10 x 1.25 mm
