umn-impish/kicad/lvps-swri/3D Models/PXG-M15-24WD05.step

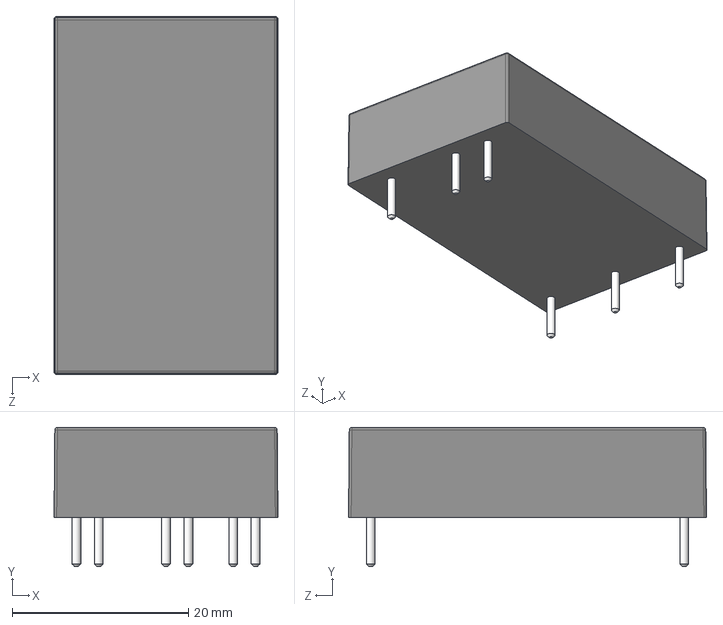
[picture p52: CAD file, 2025-06-26]
lvps-swri/3D Models/PXG-M15-24WD05.step
25.4 x 15.8 x 40.6 mm
