umn-impish/kicad/lvps-toggles-swri/3D Models/BCS-105-L-D-TE.stp

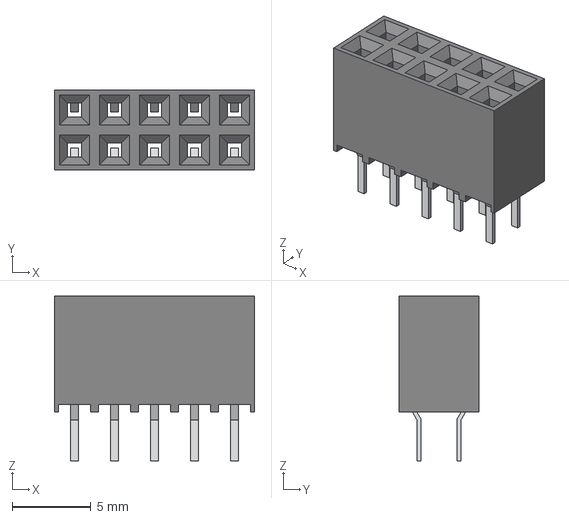
[picture p53: CAD file, 2025-09-01]
lvps-toggles-swri/3D Models/BCS-105-L-D-TE.stp
12.7 x 5.08 x 10.5 mm
