umn-impish/kicad/lvps-swri/3D Models/T495D475K050ATE275.step

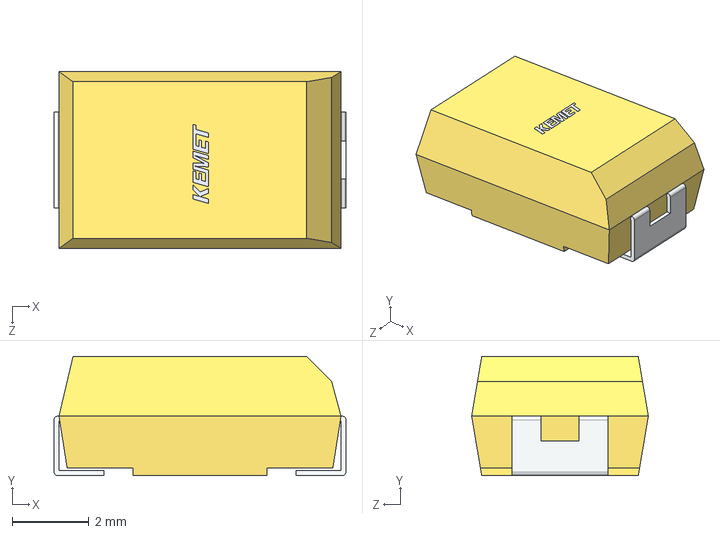
[picture p54: CAD file, 2025-06-26]
lvps-swri/3D Models/T495D475K050ATE275.step
7.60 x 3.11 x 4.60 mm
