umn-impish/kicad/lvps-toggles-swri/3D Models/BCS-110-L-D-TE.stp

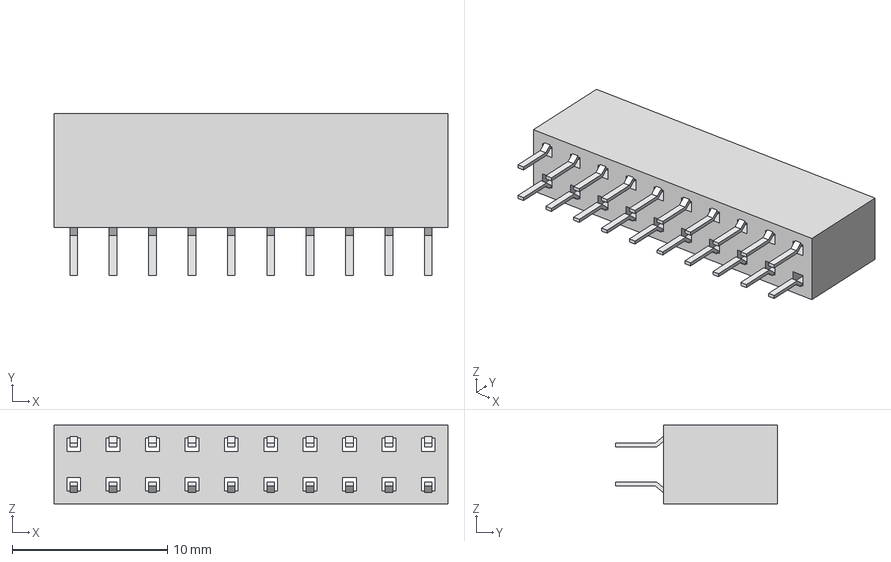
[picture p55: CAD file, 2025-09-01]
lvps-toggles-swri/3D Models/BCS-110-L-D-TE.stp
25.4 x 10.5 x 5.08 mm
BCS-110-D-TE_socket
C-95-01-10-L-D-TE
C-95-01-10-L-D-TE2
