umn-impish/kicad/lvps-swri/3D Models/BCS-117-L-D-TE.step

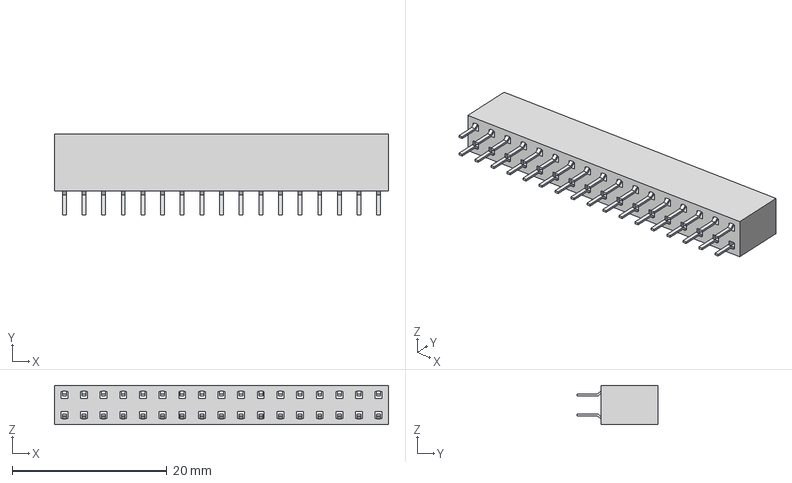
[picture p56: CAD file, 2025-06-26]
lvps-swri/3D Models/BCS-117-L-D-TE.step
43.2 x 10.5 x 5.08 mm
BCS-117-D-TE_socket
C-95-01-17-L-D-TE
C-95-01-17-L-D-TE2
