umn-impish/kicad/lvps-toggles-swri/3D Models/MTSW-117-12-L-D-840.stp

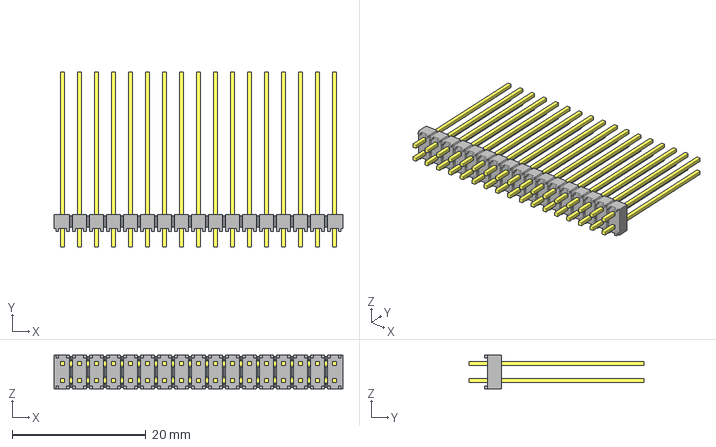
[picture p57: CAD file, 2025-09-01]
lvps-toggles-swri/3D Models/MTSW-117-12-L-D-840.stp
43.2 x 26.2 x 5.08 mm
MTSW-117-12-L-D-840_body
MTSW-117-12-D-840
