umn-impish/kicad/fc-board/models/74LVC1G07SE_7.stp

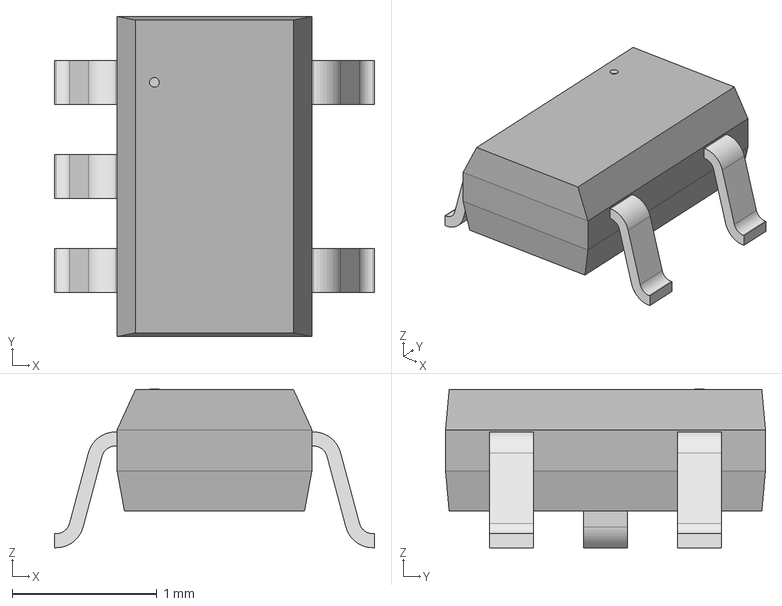
[picture p58: CAD file, 2025-11-19]
fc-board/models/74LVC1G07SE_7.stp
2.21 x 2.21 x 1.09 mm
