umn-impish/kicad/lvps-swri/3D Models/InFilter.step

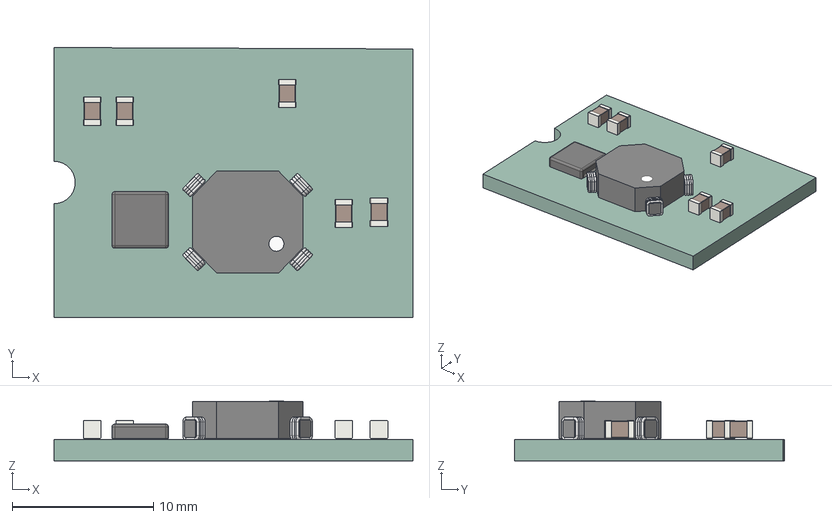
[picture p59: CAD file, 2025-06-26]
lvps-swri/3D Models/InFilter.step
25.4 x 19.1 x 4.22 mm
C_0805_2012Metric x 5
L_APV_ANR4010
CMS1-6-R
InFilter_PCB
