umn-impish/kicad/fc-board/models/TLV9004QPWRQ1.stp

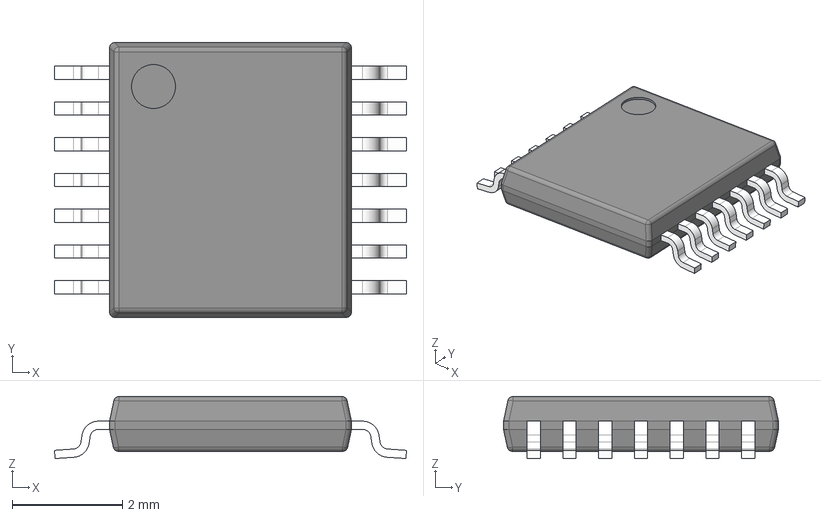
[picture p60: CAD file, 2025-11-19]
fc-board/models/TLV9004QPWRQ1.stp
6.40 x 5.00 x 1.13 mm
BODY-TSSOP
LEAD-TSSOP x 14
PIN1
