umn-impish/kicad/lvps-swri/3D Models/PXC-M03-24WD15-A.step

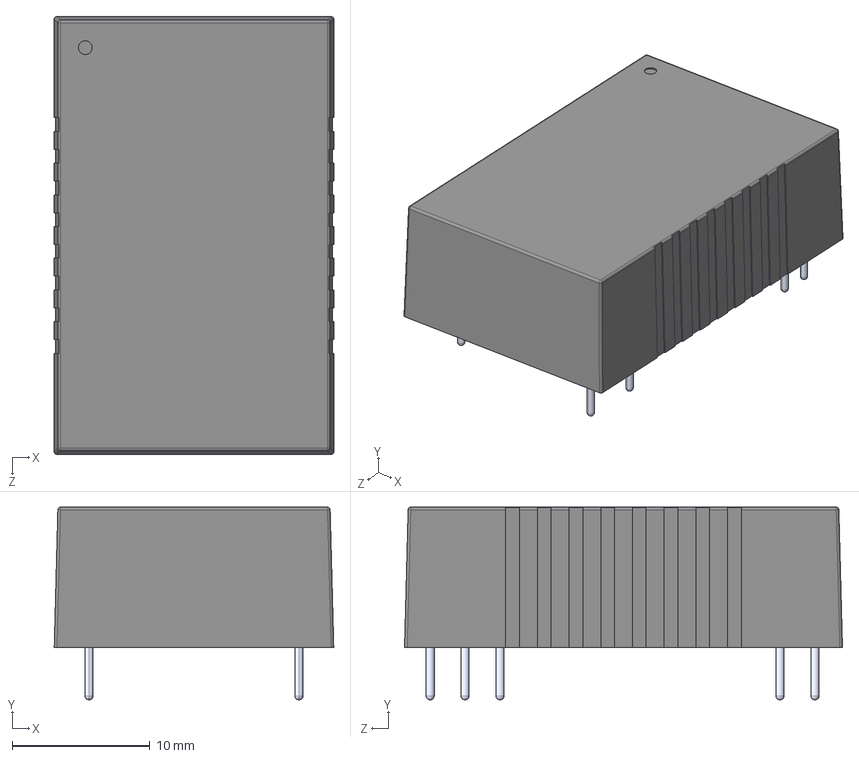
[picture p61: CAD file, 2025-06-26]
lvps-swri/3D Models/PXC-M03-24WD15-A.step
20.3 x 14.0 x 31.8 mm
