umn-impish/kicad/fc-board/models/MTSW-110-13-L-D-1060.stp

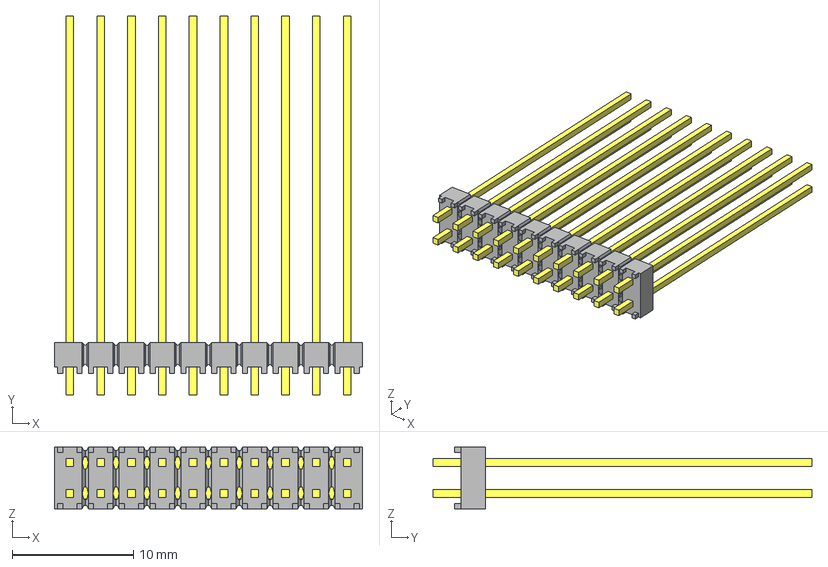
[picture p62: CAD file, 2025-11-19]
fc-board/models/MTSW-110-13-L-D-1060.stp
25.4 x 31.2 x 5.08 mm
MTSW-110-13-L-D-1060_body
MTSW-110-13-D-1060
