umn-impish/kicad/fc-board/models/PTS0805M1B500RP100.stp

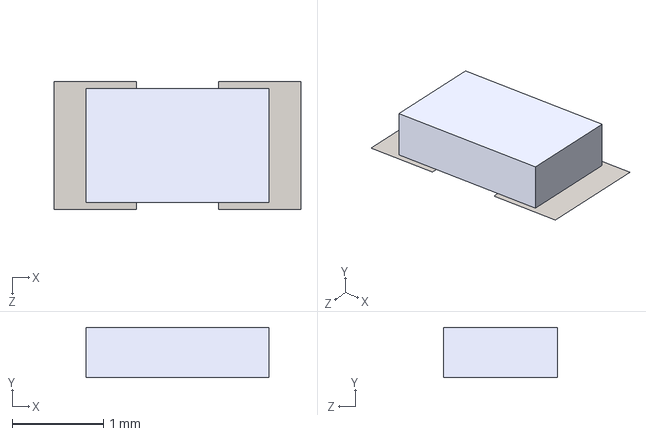
[picture p63: CAD file, 2025-11-19]
fc-board/models/PTS0805M1B500RP100.stp
2.70 x 0.55 x 1.40 mm
