umn-impish/kicad/lvps-swri/3D Models/SMPA.step

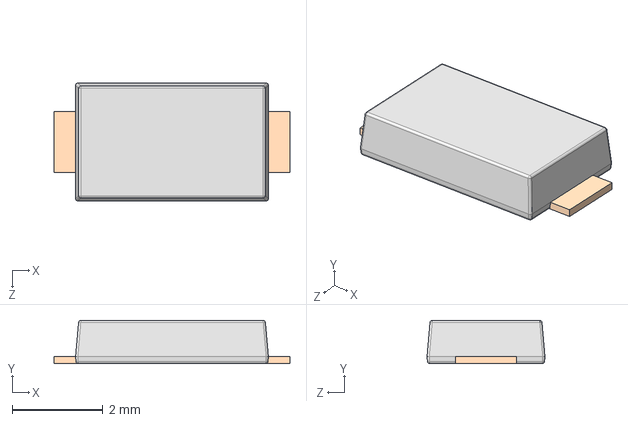
[picture p64: CAD file, 2025-06-26]
lvps-swri/3D Models/SMPA.step
5.20 x 0.95 x 2.60 mm
