umn-impish/kicad/fc-board/models/microsd-card.stp

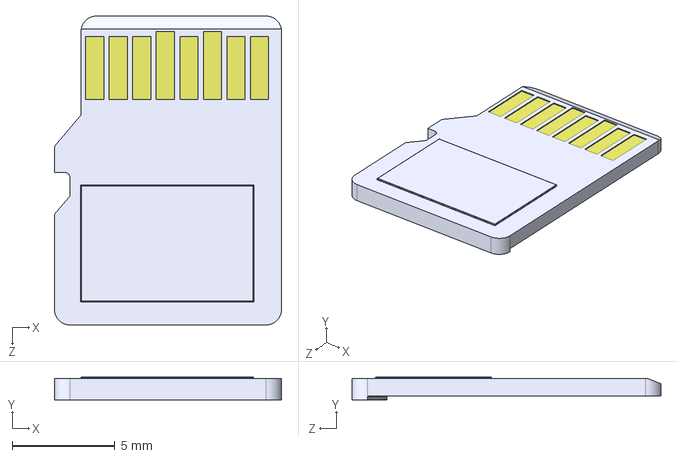
[picture p65: CAD file, 2025-11-19]
fc-board/models/microsd-card.stp
11.0 x 1.12 x 15.0 mm
