umn-impish/kicad/lvps-swri/3D Models/GA342QR7GF101KW01L.step

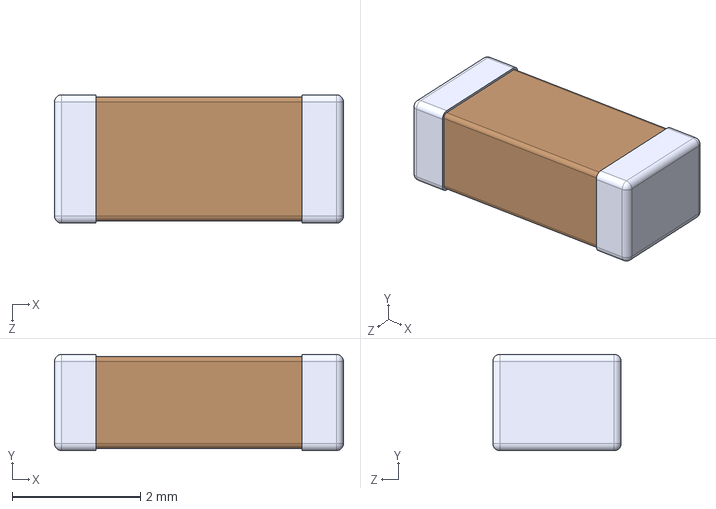
[picture p66: CAD file, 2025-06-26]
lvps-swri/3D Models/GA342QR7GF101KW01L.step
4.50 x 1.50 x 2.00 mm
