umn-impish/kicad/fc-board/models/molex-503398-1892.stp

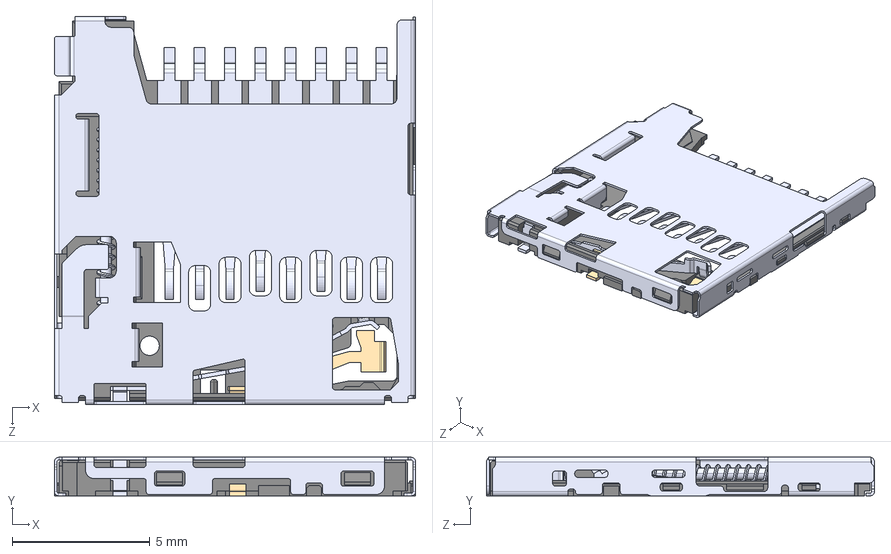
[picture p67: CAD file, 2025-11-19]
fc-board/models/molex-503398-1892.stp
13.1 x 1.40 x 14.1 mm
