umn-impish/kicad/fc-board/models/CR-1220-FCN.stp

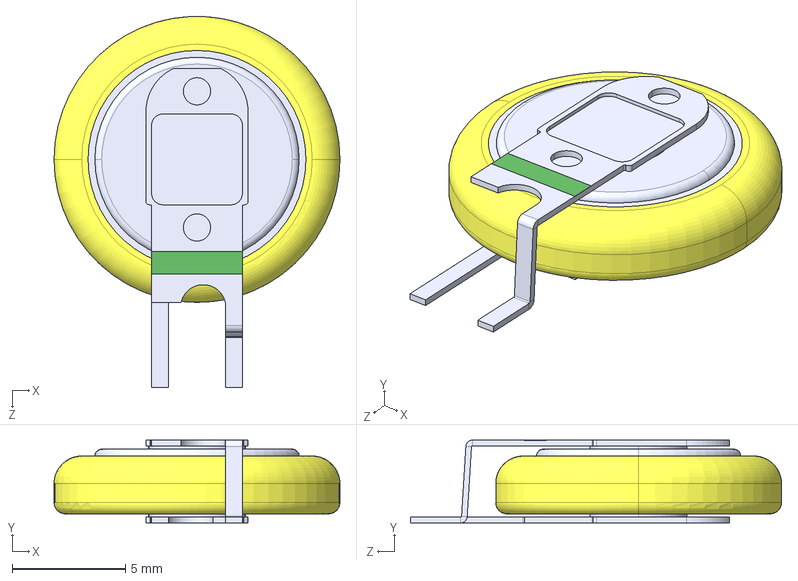
[picture p68: CAD file, 2025-11-19]
fc-board/models/CR-1220-FCN.stp
12.6 x 3.65 x 16.3 mm
