umn-impish/kicad/fc-board/models/RT9742GGJ5.stp

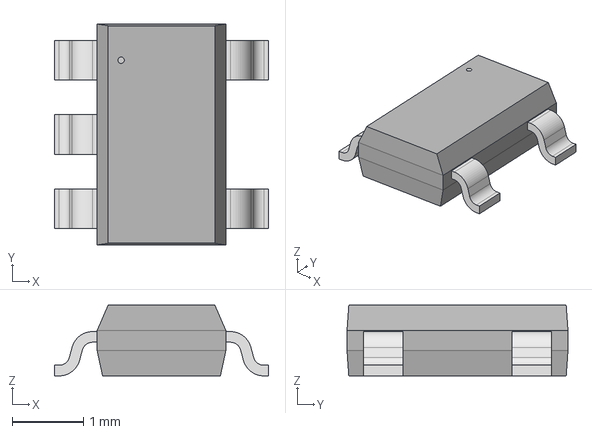
[picture p69: CAD file, 2025-11-19]
fc-board/models/RT9742GGJ5.stp
3.00 x 3.10 x 0.993 mm
