umn-impish/kicad/lvps-swri/3D Models/IND_SDS680R_API.step

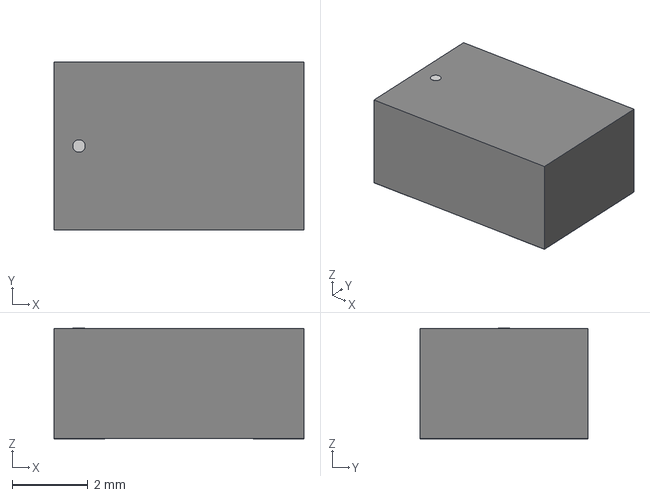
[picture p70: CAD file, 2025-06-26]
lvps-swri/3D Models/IND_SDS680R_API.step
6.60 x 4.44 x 2.92 mm
