umn-impish/kicad/fc-board/models/ADS122C04IPWR.stp

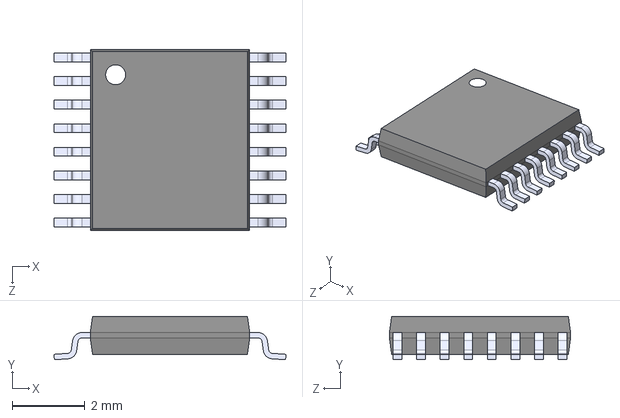
[picture p71: CAD file, 2025-11-19]
fc-board/models/ADS122C04IPWR.stp
6.40 x 1.20 x 5.00 mm
