umn-impish/kicad/lvps-swri/3D Models/CCG30-24-12S.step

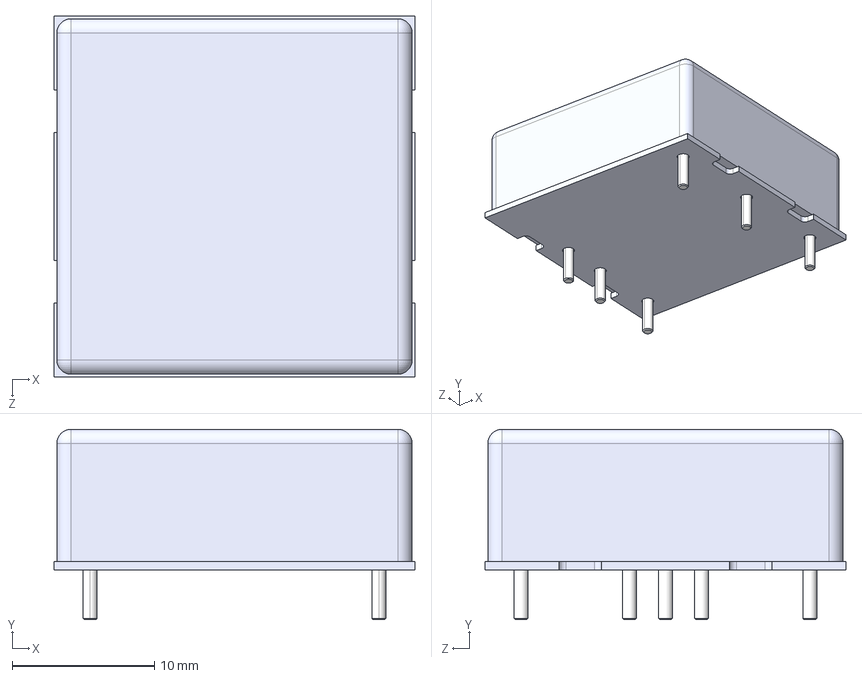
[picture p72: CAD file, 2025-06-26]
lvps-swri/3D Models/CCG30-24-12S.step
25.4 x 13.4 x 25.4 mm
