umn-impish/kicad/fc-board/models/REF3425TIDBVR.stp

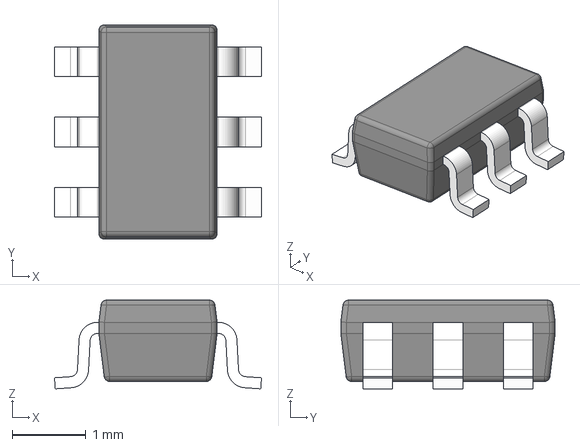
[picture p73: CAD file, 2025-11-19]
fc-board/models/REF3425TIDBVR.stp
2.80 x 2.90 x 1.20 mm
BODY-SOT
LEAD-SOT x 6
