umn-impish/kicad/fc-board/models/MTSW-104-13-L-D-1060.stp

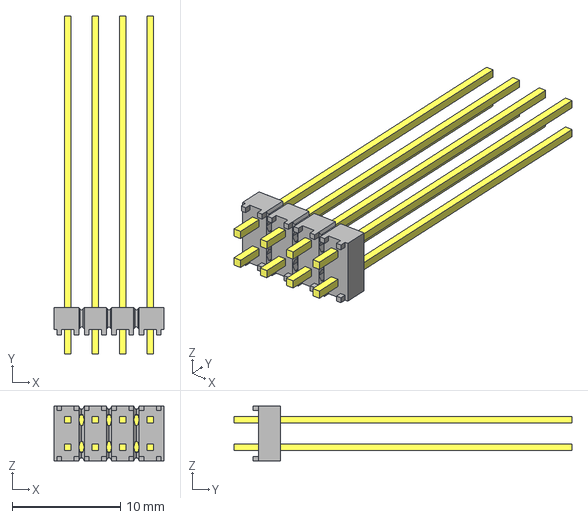
[picture p74: CAD file, 2025-11-19]
fc-board/models/MTSW-104-13-L-D-1060.stp
10.2 x 31.2 x 5.08 mm
MTSW-104-13-L-D-1060_body
MTSW-104-13-D-1060
