umn-impish/kicad/fc-board/models/DSC1001CI2-025-0000T.stp

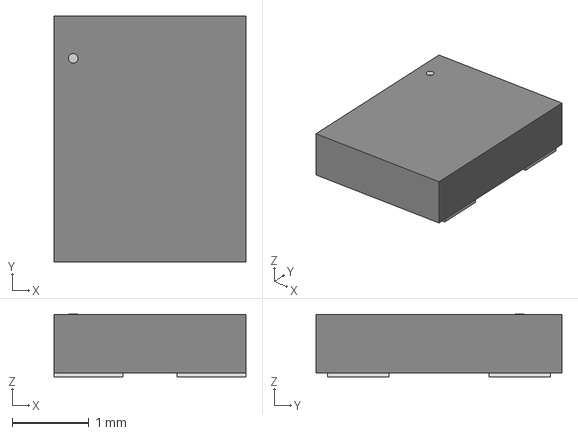
[picture p75: CAD file, 2025-11-19]
fc-board/models/DSC1001CI2-025-0000T.stp
2.50 x 3.20 x 0.815 mm
