umn-impish/kicad/fc-board/models/LAN7430T-I-Y9X.stp

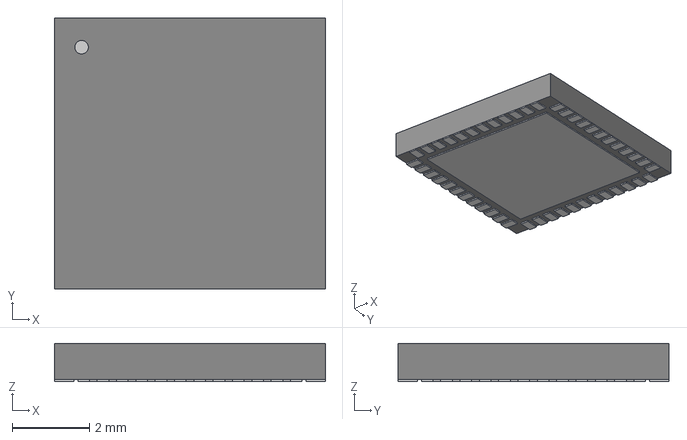
[picture p76: CAD file, 2025-11-19]
fc-board/models/LAN7430T-I-Y9X.stp
7.01 x 7.01 x 0.993 mm
