umn-impish/kicad/fc-board/models/MMCX-J-P-H-ST-EM1.stp

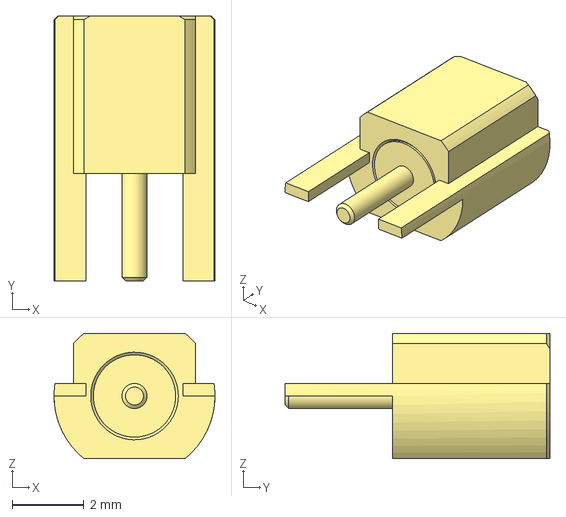
[picture p77: CAD file, 2025-06-12]
fc-board/models/MMCX-J-P-H-ST-EM1.stp
4.50 x 7.40 x 3.50 mm
