umn-impish/kicad/fc-board/models/PCT2075TP_147.stp

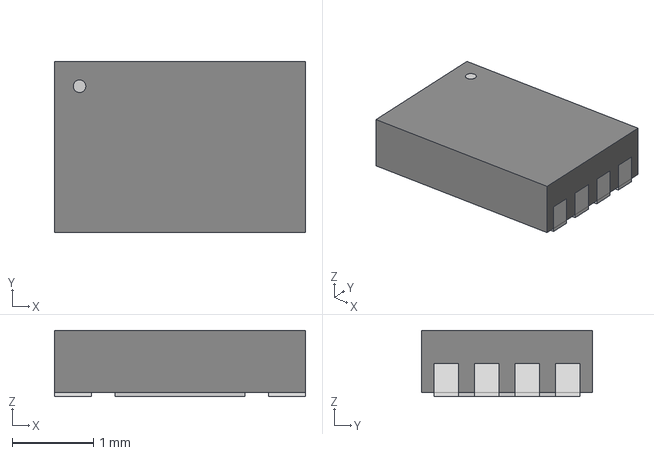
[picture p78: CAD file, 2024-10-08]
fc-board/models/PCT2075TP_147.stp
3.10 x 2.11 x 0.815 mm
