umn-impish/kicad/fc-board/models/DS3231M_TRL.stp

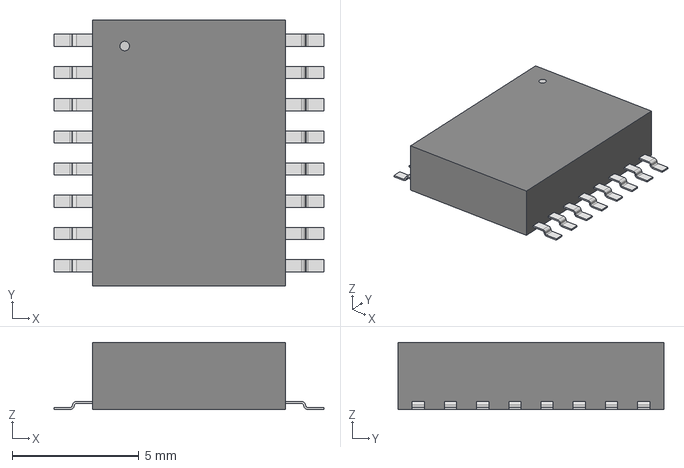
[picture p79: CAD file, 2024-10-08]
fc-board/models/DS3231M_TRL.stp
10.6 x 10.5 x 2.64 mm
