umn-impish/kicad/fc-board/models/msxs-08pffr-sf7002.stp

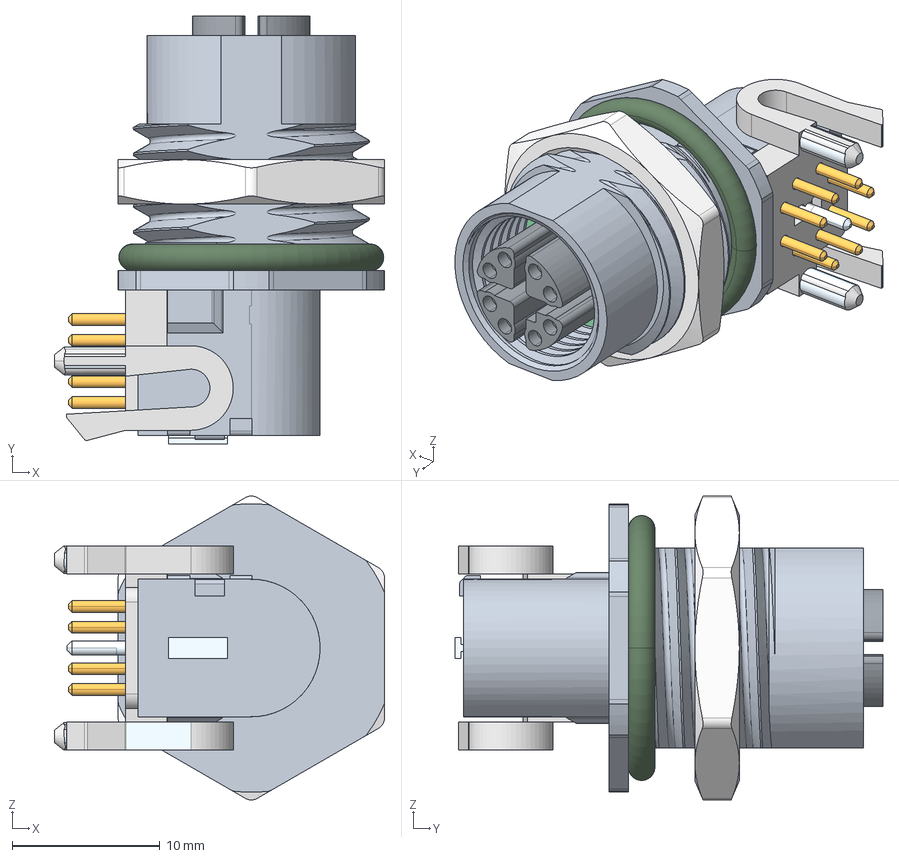
[picture p80: CAD file, 2024-10-08]
fc-board/models/msxs-08pffr-sf7002.stp
22.3 x 28.9 x 20.5 mm
