umn-impish/kicad/fc-board/models/BAS7002VH6327XTSA1.stp

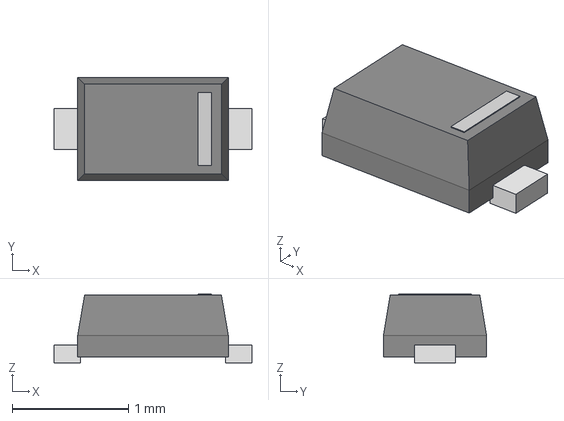
[picture p81: CAD file, 2024-10-08]
fc-board/models/BAS7002VH6327XTSA1.stp
1.70 x 0.888 x 0.591 mm
