umn-impish/kicad/(list of files, cad)

Other CAD files:
fc-board/models/BCS-110-L-D-TE.stp
lvps-swri/3D Models/BCS-110-L-D-TE.step
lvps-swri/3D Models/AM5TW-2407D-RZ.step
lvps-swri/3D Models/PXC-M03-24WS05-A.step
bias-supply/components/ISL22317WFRTZ/ISL22317WFRTZ.stp
bias-supply/components/MAX44243ASD+/MAX44243ASD+.stp
fc-board/models/10103594-0001LF.stp
fc-board/models/749023310.stp
fc-board/models/M80_5000442.stp
fc-board/models/MAX11617EEE+.stp
fc-board/models/SM91509AL-E.stp
lvps-toggles-adapter/parts/m80 8 pin right/m80-5300842.stp
lvps-toggles-adapter/parts/molex 4pin/5031750400.stp
lvps-toggles-swri/3D Models/AP22804AW5-7.stp
peak-holder/components/mmcx-straight-molex/734151472.stp
peak-holder/components/phoenix 1729131/1729131.step
sipm-carrier-flight/components/JTek-M80-board/M80-5T10642MC.stp
sipm-carrier-flight/components/MAL218697001E3.step
sipm-carrier-flight/components/Molex 0732511150/732511150.stp
