umn-impish/kicad/peak-holder/peak-holder.pdf

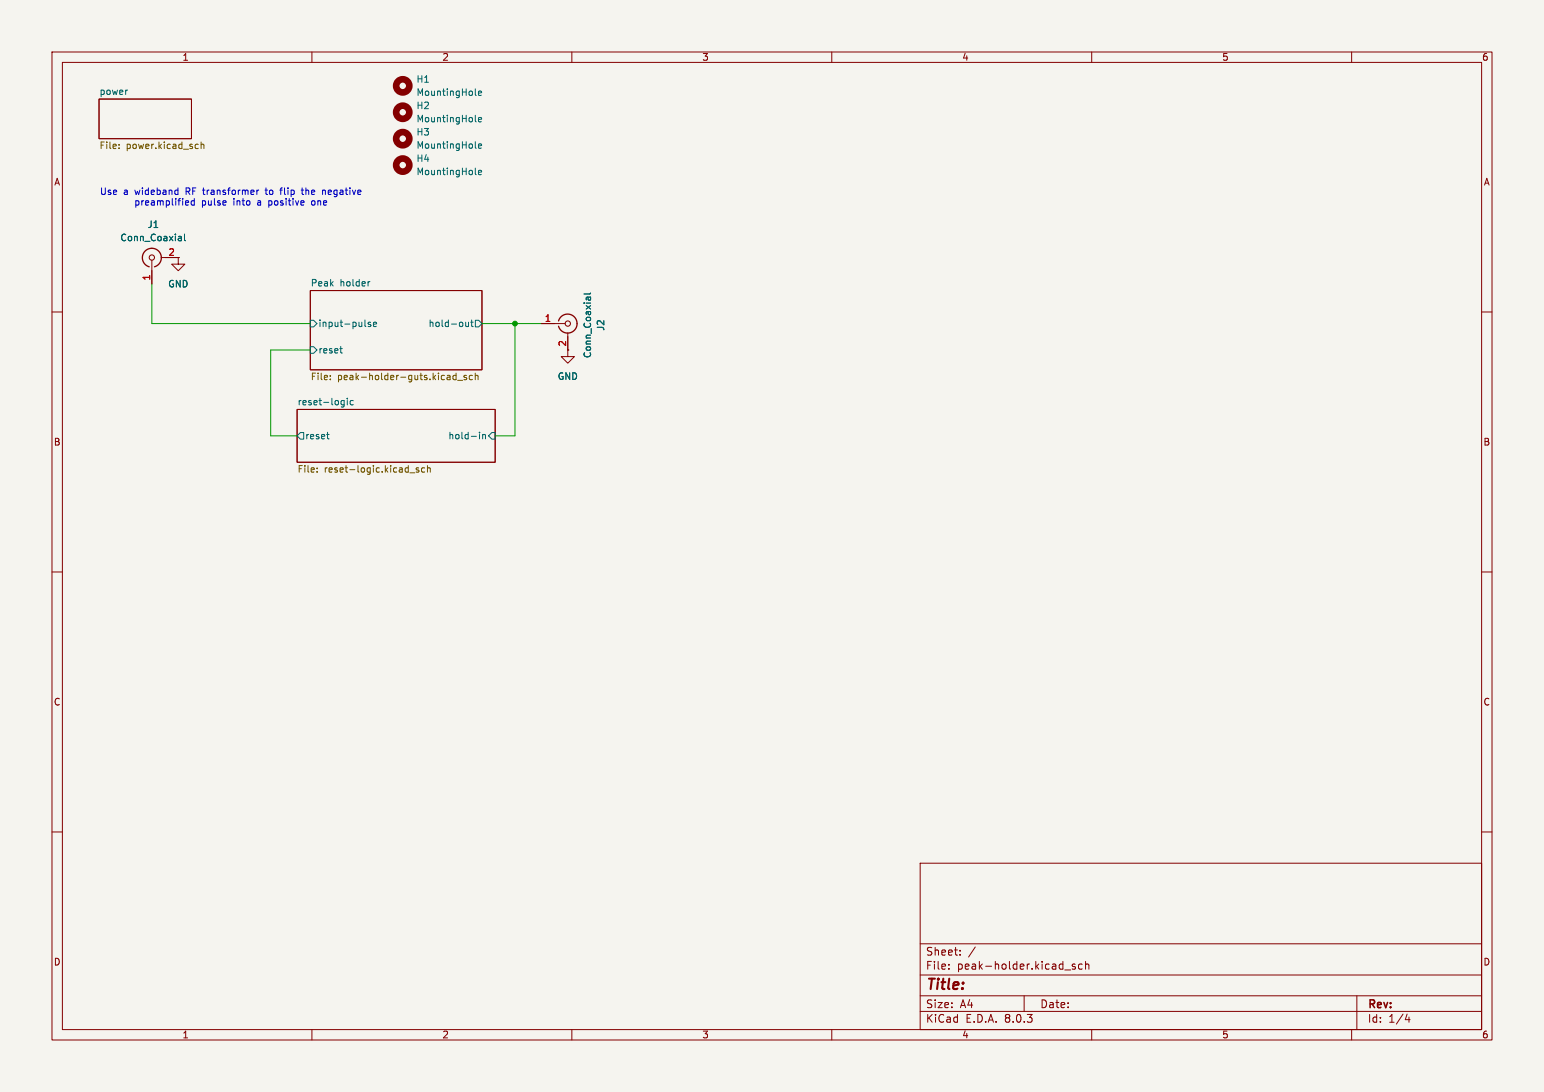
[picture p82: page 1]

reset-logic File: reset-logic.kicad_sch

Id: 1/4 Title: File: peak-holder.kicad_sch Sheet: /

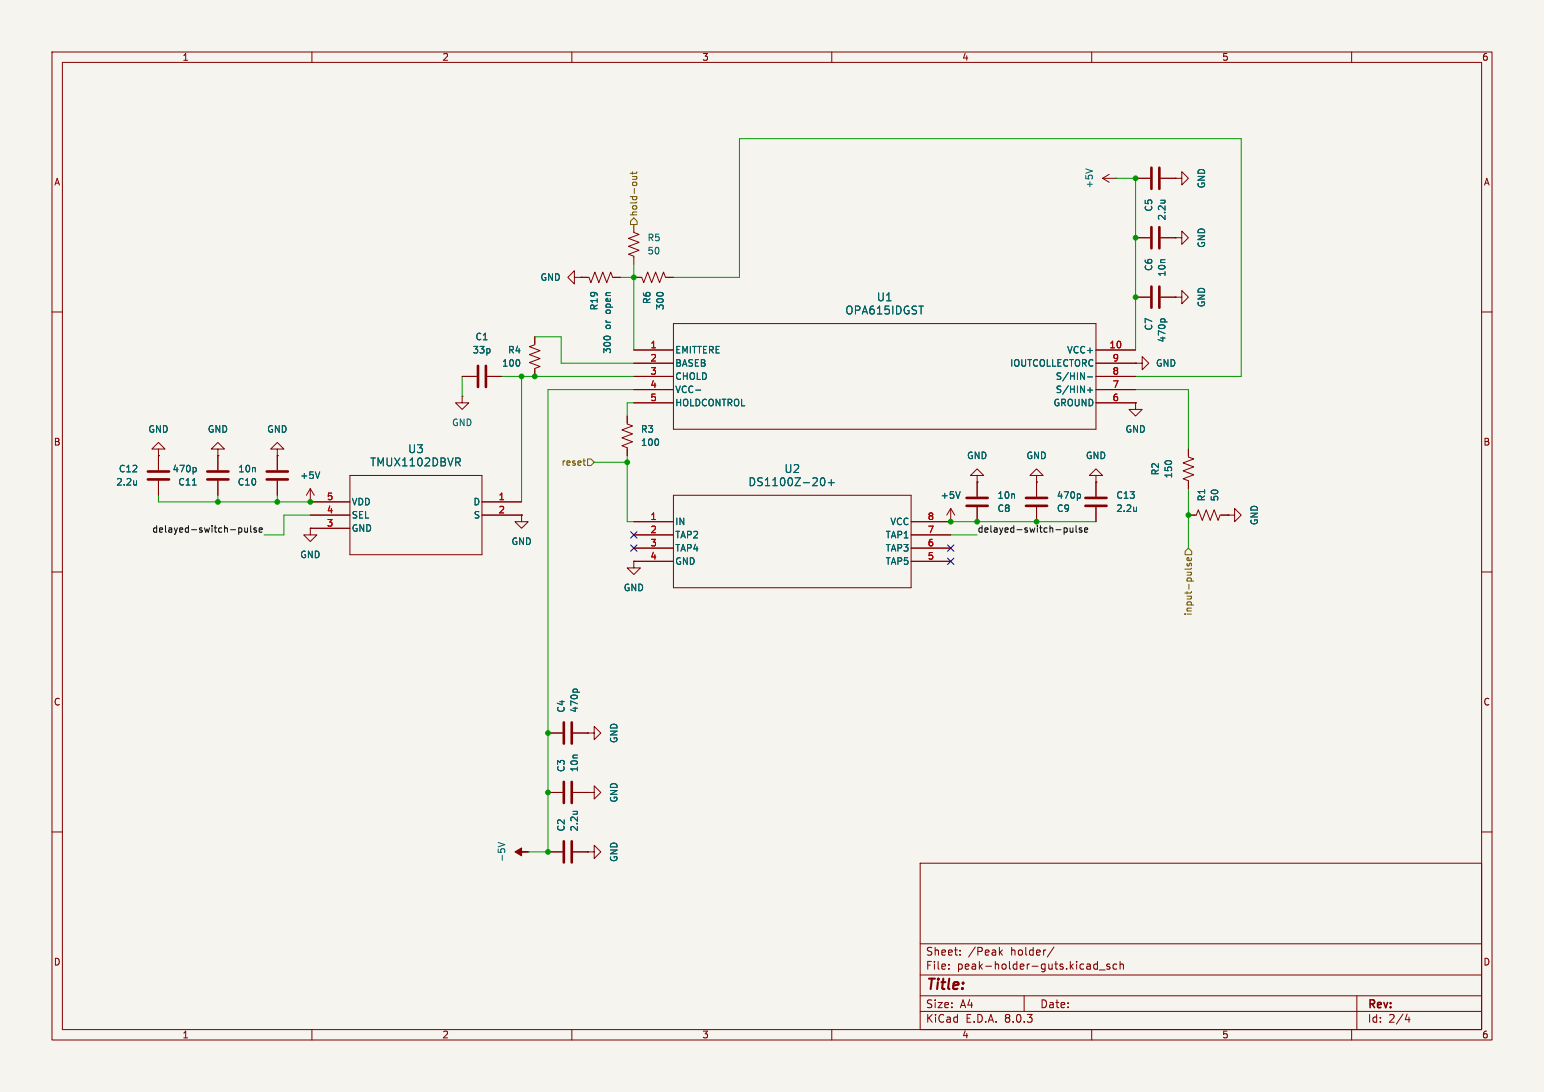
[picture p83: page 2]

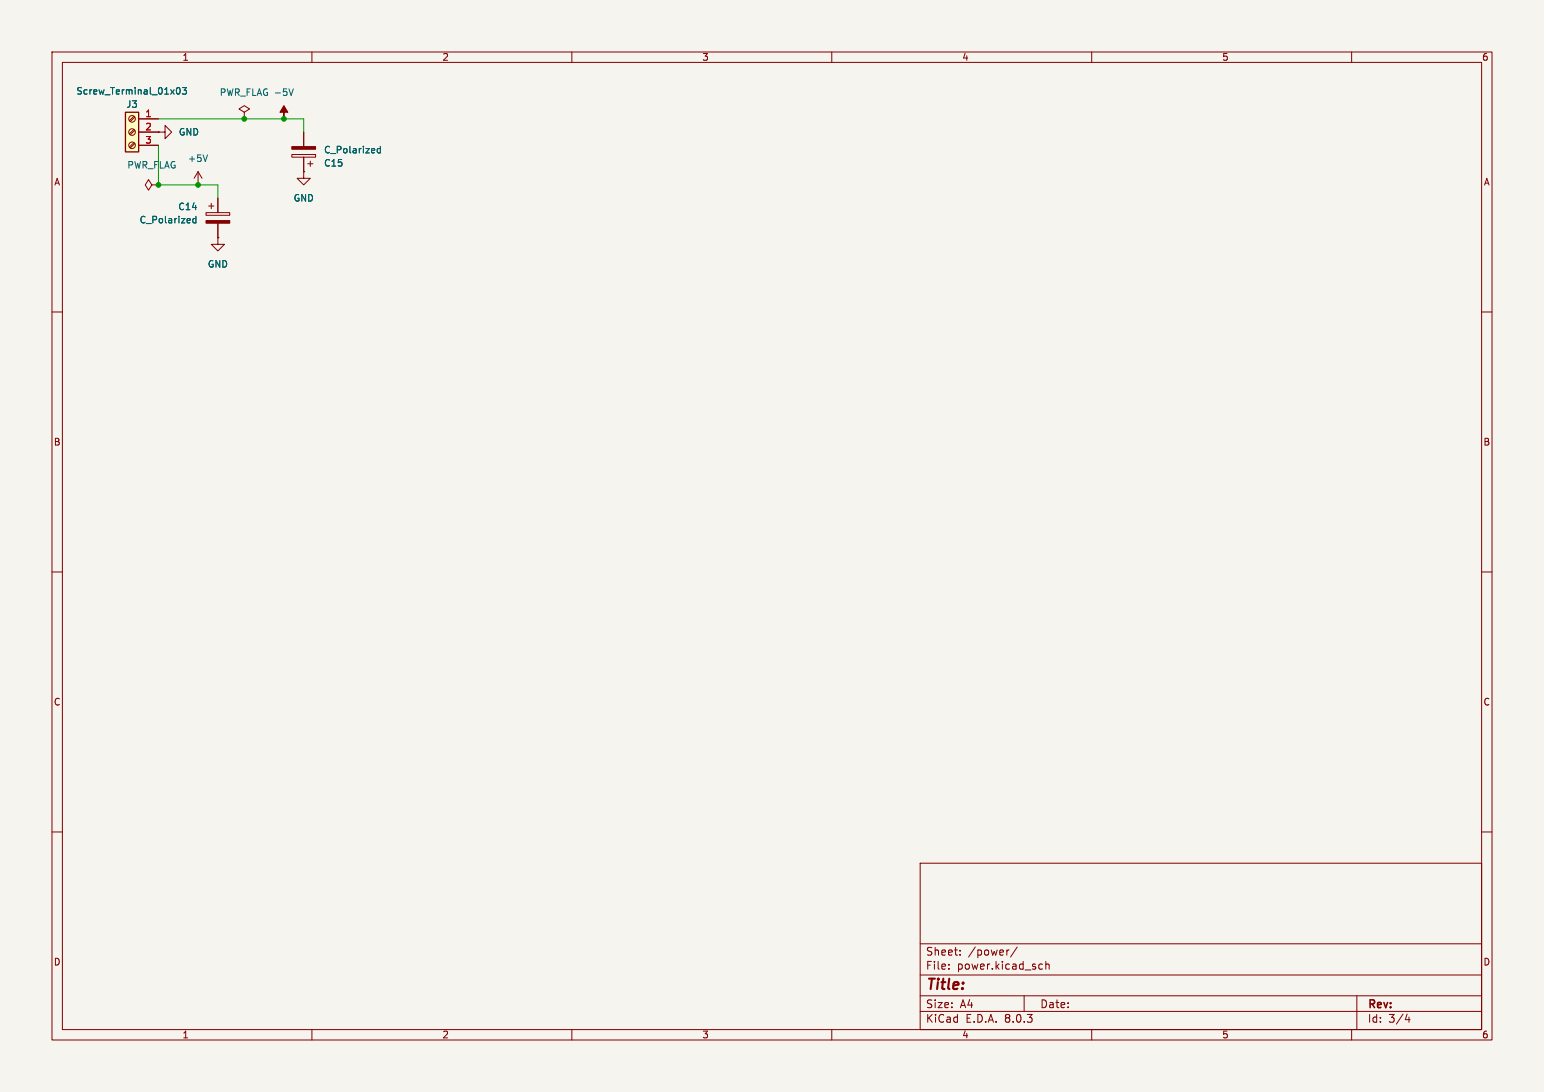
[picture p84: page 3]

Id: 3/4 Title: File: power.kicad_sch Sheet: /power/

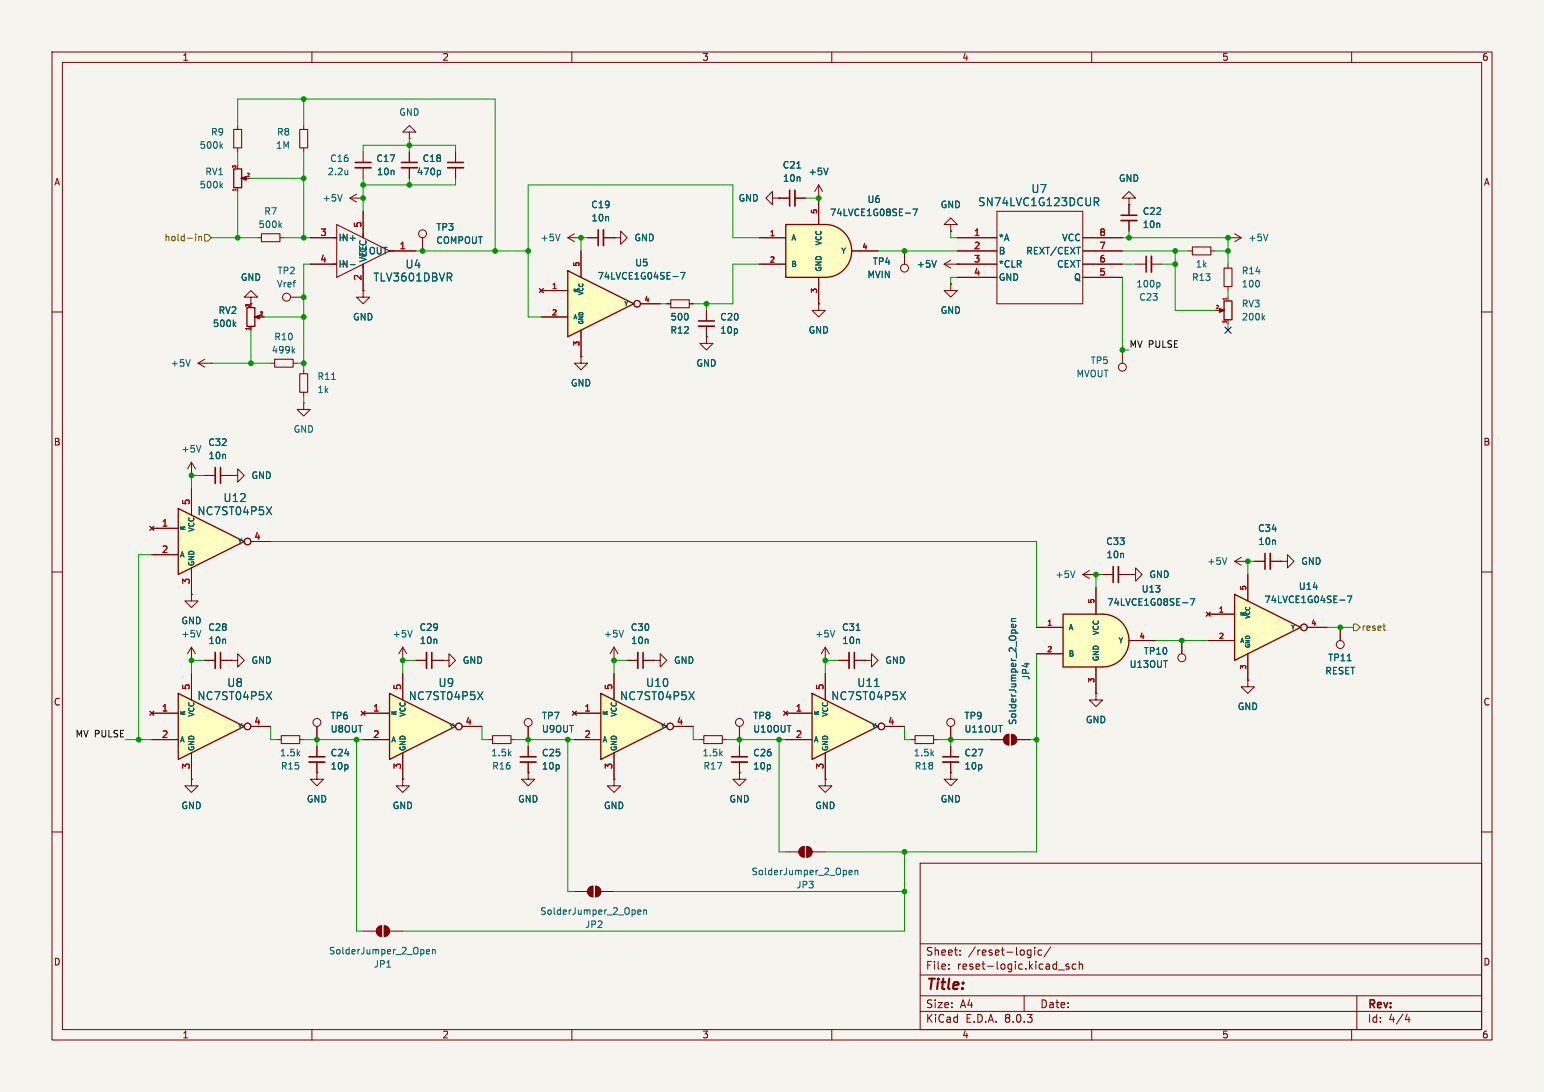
[picture p85: page 4]

Id: 4/4 Title: File: reset-logic.kicad_sch Sheet: /reset-logic/ GND
