umn-impish/kicad/bias-supply/bias-supply-schematic.pdf

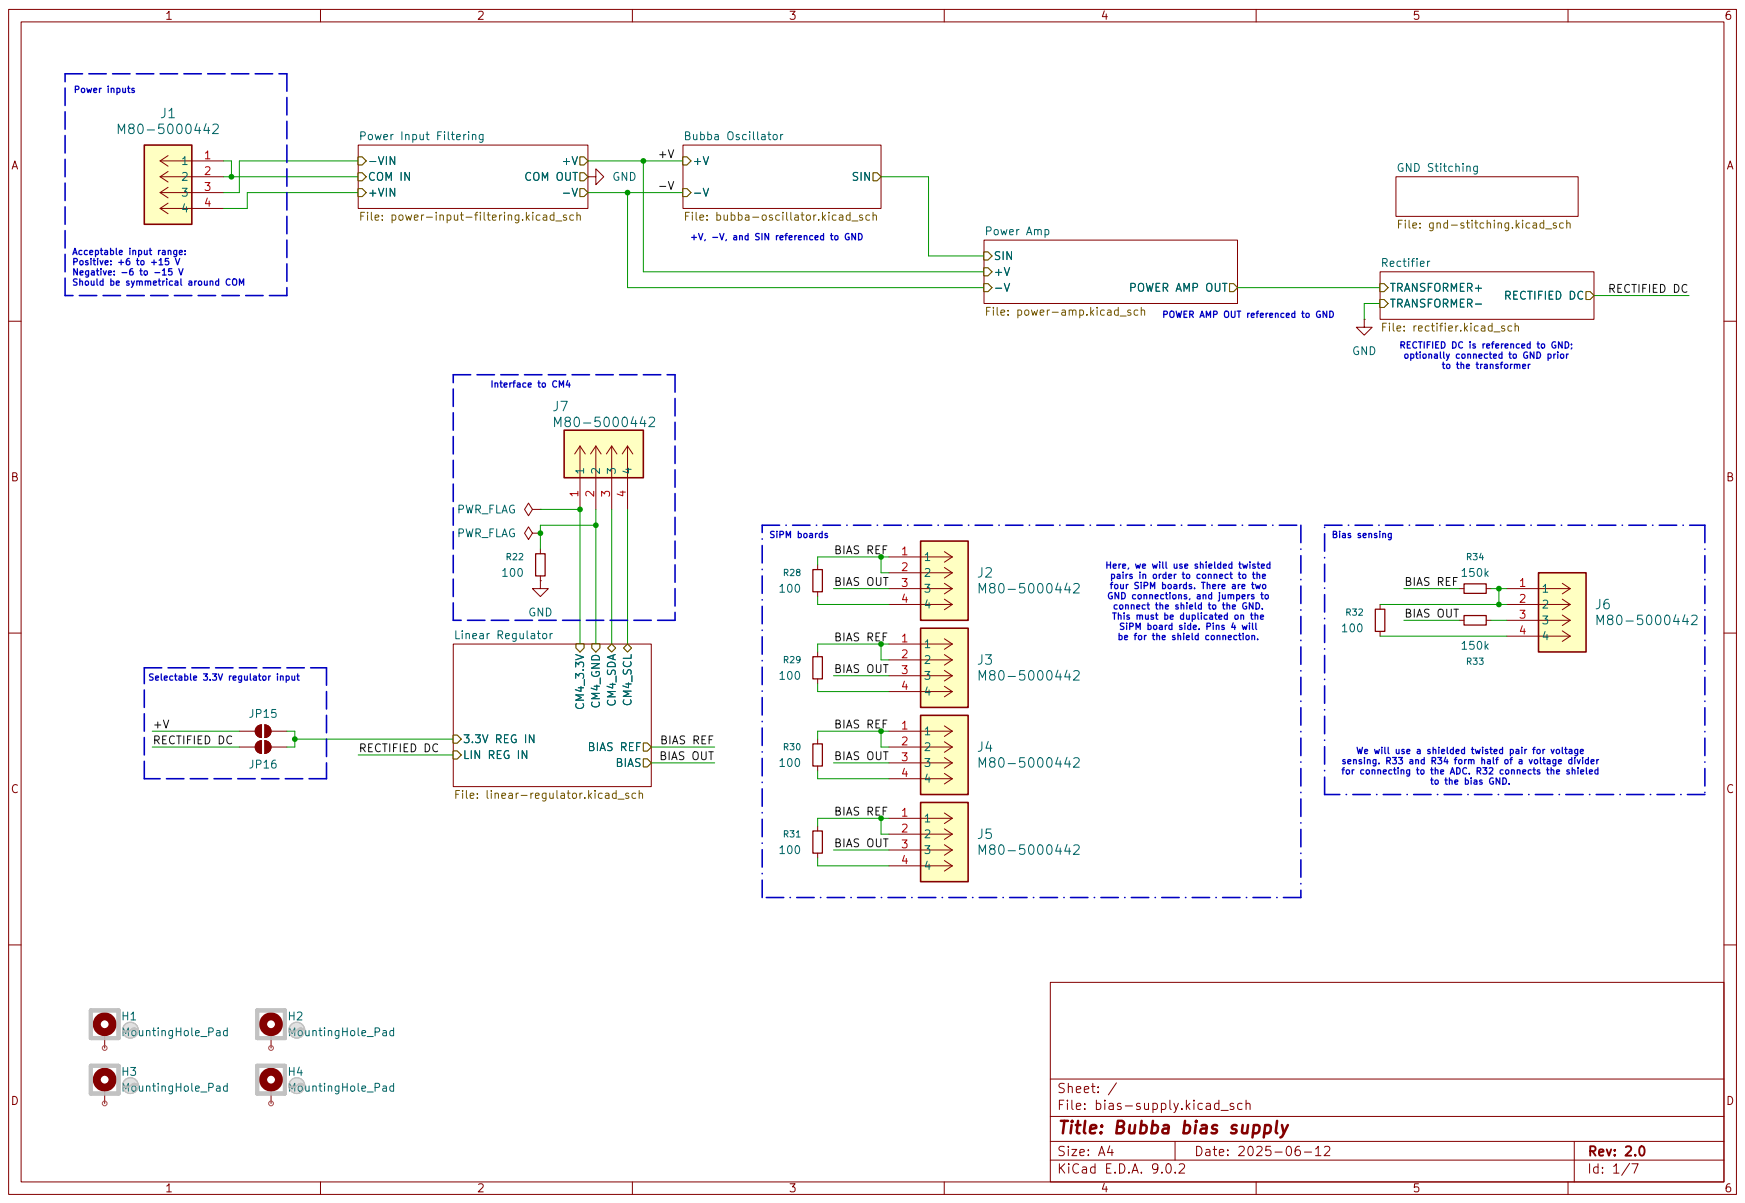
[picture p86: page 1]

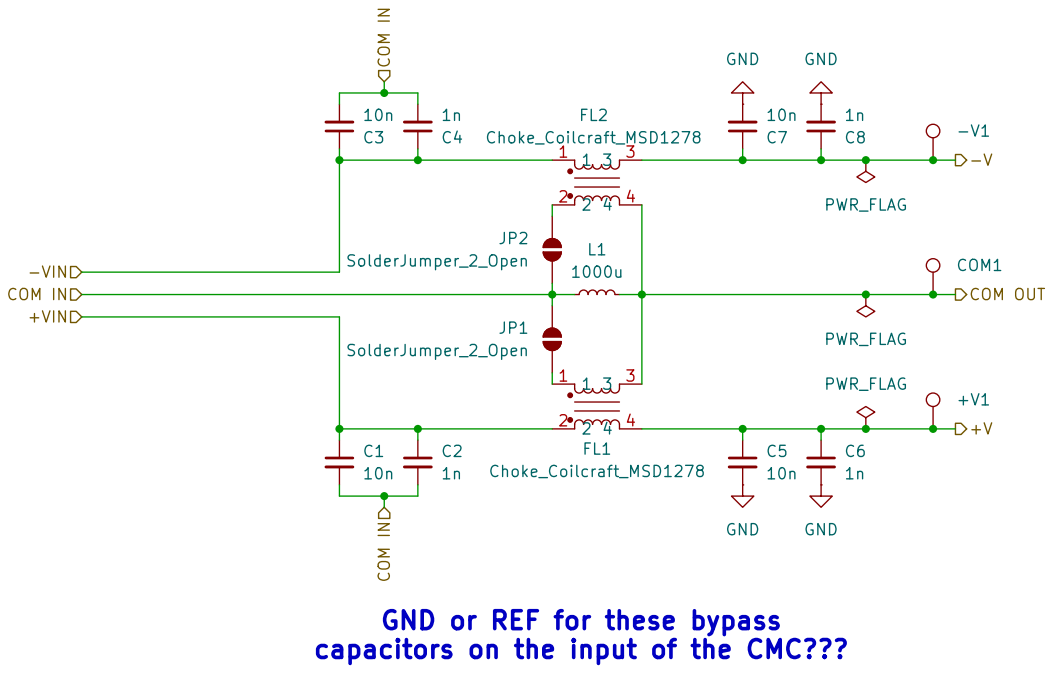
[picture p87: page 2]

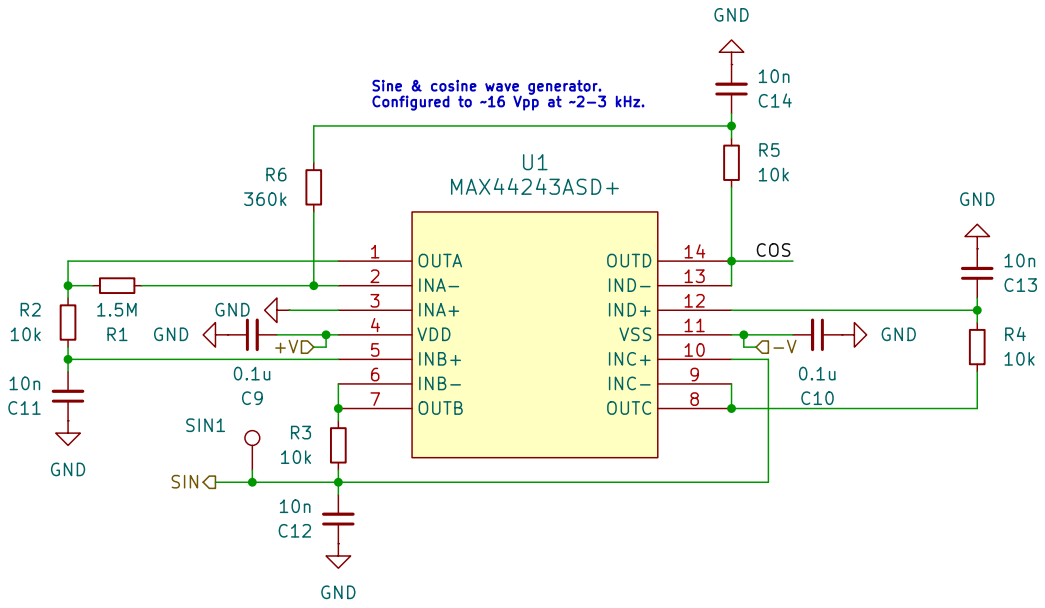
[picture p88: page 3]

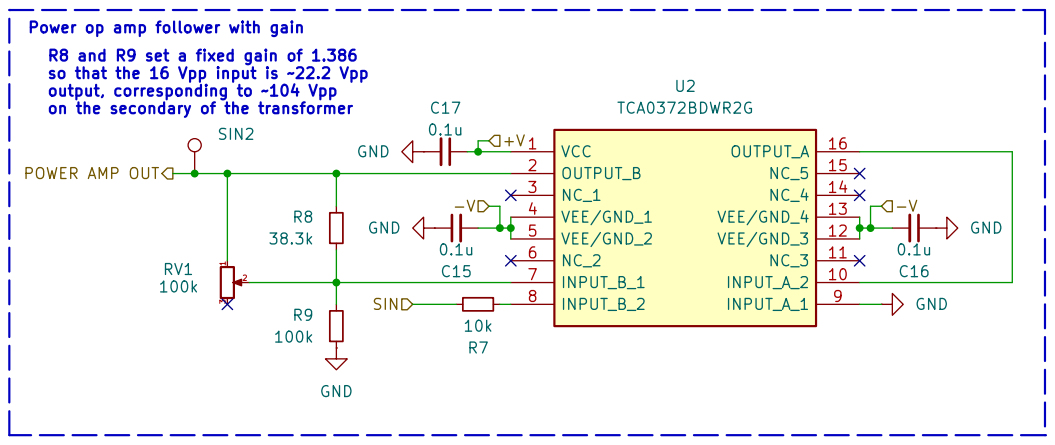
[picture p89: page 4]

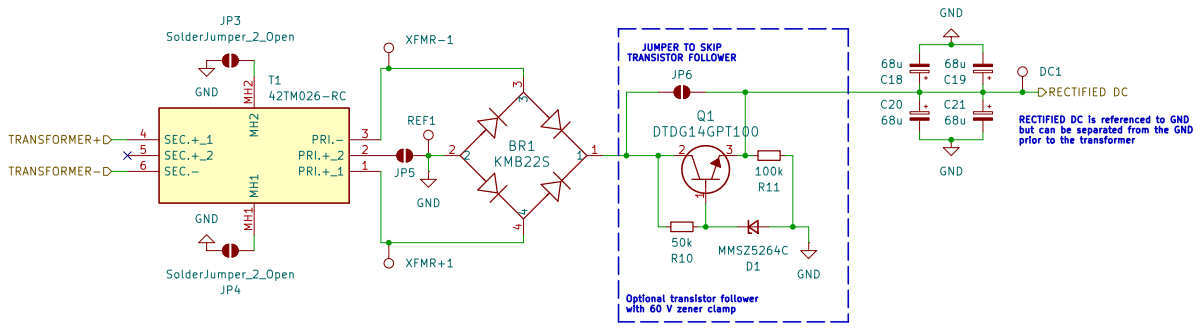
[picture p90: page 5]

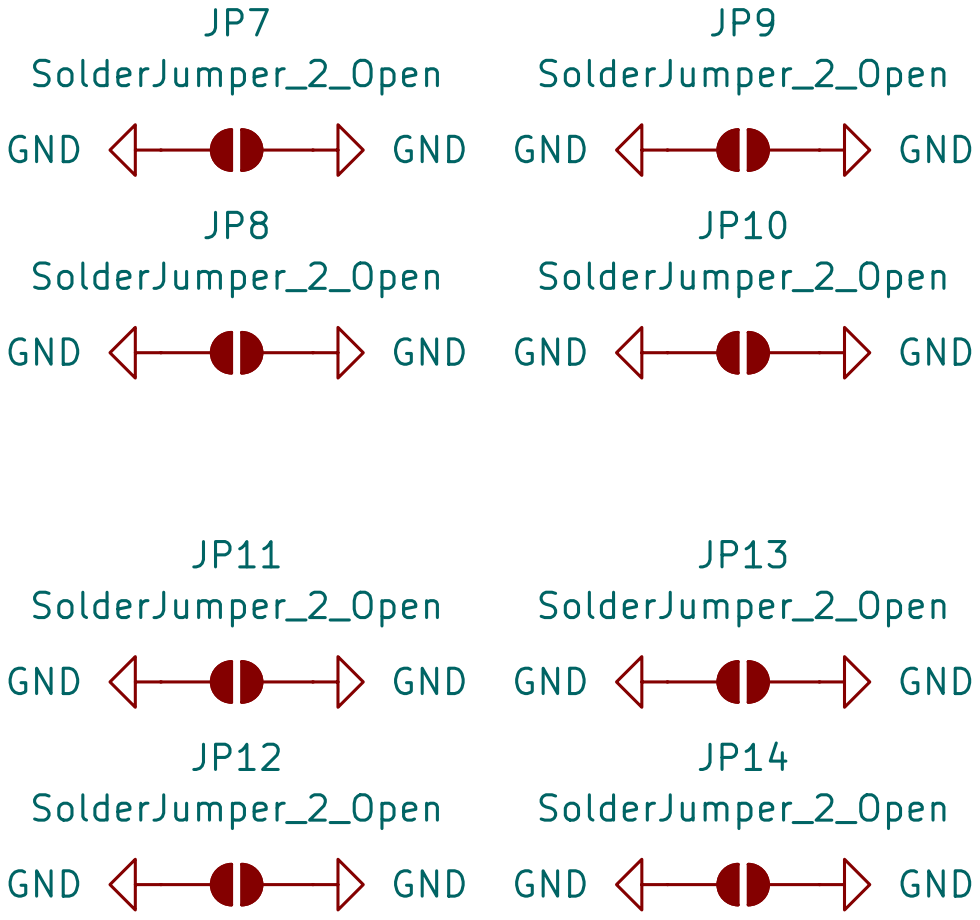
[picture p91: page 6]

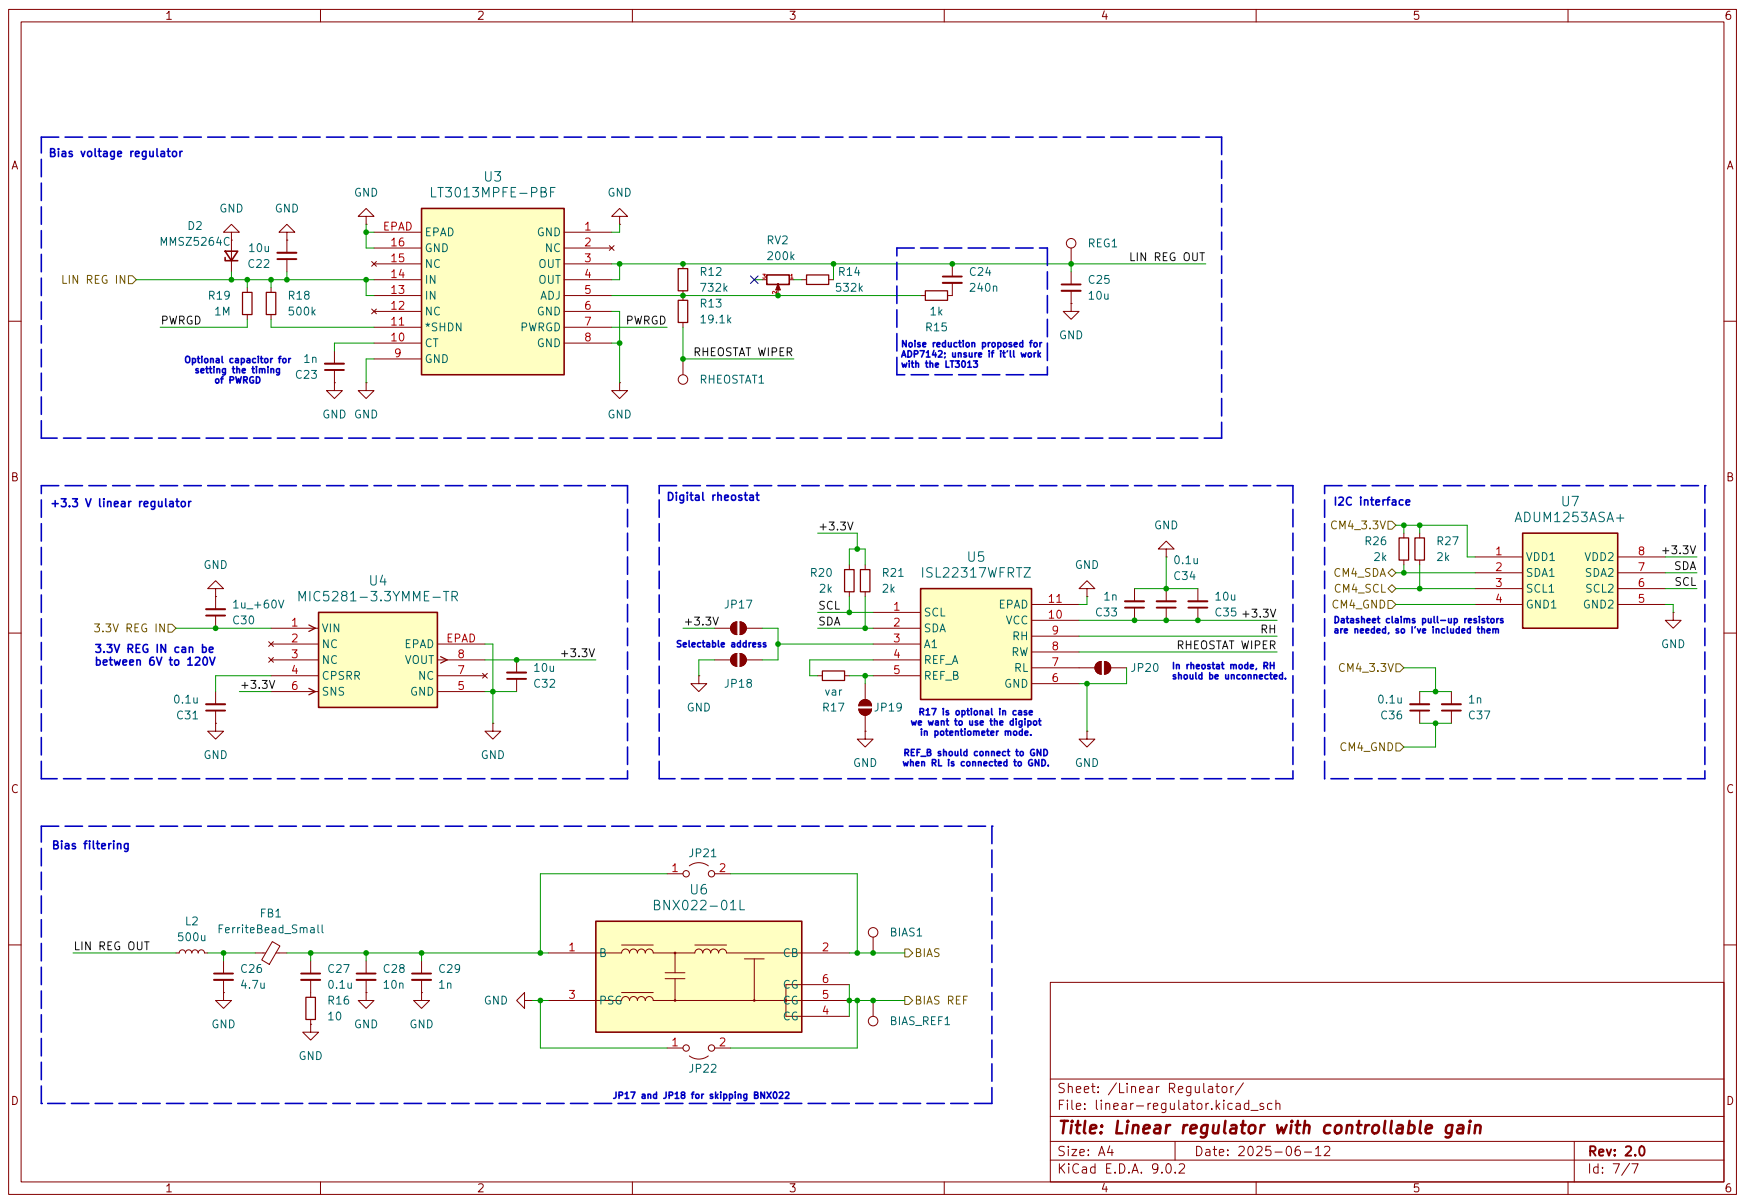
[picture p92: page 7]
