umn-impish/kicad/(commit log)

2024-10-08 Added bias supply
    [21-0041B_14_MXM.step, 42TM026-RC.stp, BNX022-01L.step, DIO_KDZLVTF100_ROM.step, MB-S_SME.step, MSD1278.step, SMA-J-P-X-ST-TH1.step, SOIC8_ADP7142ARDZ-R7_ADI.step]
2024-10-08 Added flight comptuer carrier board
    [10067847-001RLF.stp, 1062.stp, 436500424.stp, 685119134923.stp, 749023310.stp, 74LVC1G07SE_7.stp, ADS1013BQDGSRQ1.stp, ADS1015BQDGSRQ1.stp]
2024-10-10 readout for onsemi sipms (no amp)
    [734151472.stp, DF13-3P-1.25DSA.stp, MICROFC-60035-SMT-TR1.step, SMA-J-P-X-ST-TH1.step, SMP-PF-P-HG-ST-TH2.step, SMP-PF-P-HG-ST-TH2.stp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]
2024-10-10 test board for TIA/CSP
    [734151472.stp, CP-8-27_ADI.step, D0008A.stp, DFN-12_DE_LIT.step, LTC6268HS8-10_PBF.step, MICROFC-60035-SMT-TR1.step, R_8_ADI.step, driven-tia.kicad_sch]
2024-10-10 ten-sipm carrier board (angled)
    [10sipm-for-angled.kicad_pcb, 10sipm-for-angled.kicad_sch, 732511150.stp, D0008A.stp, EMPCB.SMAFSTJ.B.HT.step, LTC6268HS8-10_PBF.step, M80-5T10642MC.stp, MICROFC-60035-SMT-TR1.step]
2024-10-10 Added peak holding circuit
    [1729131.step, 21-0041B_8_MXM.step, 3214W-1-504E.step, 734151472.stp, 74LVCE1G04SE-7.step, 74LVCE1G08SE-7.step, Coilcraft-PWB Series.STEP, DBV0005A.stp]
2024-10-11 Added test points to I2C lines
    [fc-board.kicad_pcb, fc-board.kicad_sch]
2024-10-24 Sipm board revisions (#1)
    * begin fixing 10-sipm angled readout pcb
    * update sipm board
    - new linear regulators
    - correct TIA pins (jfc)
    - more random vias/fencing
    ...
    * Moved connector to back side
    * add capacitor model with correct dimensions
    * touch ups before production of sipm board
    - SiPM footprints: better for soldering
    - Via stitching: just do it by hand
    - Output SMA jack: make trace fatter and ground plane exclusion zone larger
    * fencing vias near power plug
    * move connector and mounting hole
    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
    [10sipm-for-angled.kicad_pcb, 10sipm-for-angled.kicad_sch, CONSMA020.062-G.step, CP-8-27_ADI.step, MAL218697001E3.step, driven-tia.kicad_sch, sipm-bias-filter.kicad_sch, tia-2v5.kicad_sch]
2024-12-06 capacitor on -6V was flipped
    [10sipm-for-angled.kicad_pcb, tia-m2v5.kicad_sch]
2024-12-20 add PCB shape for "basic" flight boards
    [flight-pcb-outline.kicad_pcb, flight-pcb-outline.kicad_sch]
2025-02-10 schematic bones for shaper
    [-2v5reg.kicad_sch, 2v5reg.kicad_sch, OPA354AIDBVR.step, RFPC-SMA28-F.step, active integrator shaper.kicad_pcb, active integrator shaper.kicad_sch, inverter.kicad_sch, reset logic.kicad_sch]
2025-02-11 add integration portion
    [resettable integrator.kicad_sch]
2025-02-26 update sipm board pre-em
    [10sipm-for-angled.kicad_pcb, 10sipm-for-angled.kicad_sch, driven-tia.kicad_sch, single-sipm.kicad_sch, sipm-bias-filter.kicad_sch, sipms.kicad_sch]
2025-02-28 remove shaper; not using
    [-2v5reg.kicad_sch, 10 SiPM detector board v3.step, 10 SiPM detector board v3p1.step, 2v5reg.kicad_sch, OPA354AIDBVR.step, RFPC-SMA28-F.step, active integrator shaper.kicad_pcb, active integrator shaper.kicad_sch]
2025-03-17 touch up 10 sipm cseries
    [10sipm-for-angled.kicad_pcb]
2025-03-17 broadcom board v1
    [10sipm-for-angled.kicad_pcb, 10sipm-for-angled.kicad_sch, AFBR-S4N66P014M.stp, driven-tia.kicad_sch, single-sipm.kicad_sch, sipm-bias-filter.kicad_sch, sipms.kicad_sch, tia-2v5.kicad_sch]
2025-03-21 eleven broadcom sipms
    [10sipm-for-angled.kicad_pcb, single-sipm.kicad_sch, sipms.kicad_sch]
2025-03-21 touch up broadcom
    [10sipm-for-angled.kicad_pcb, 10sipm-for-angled.kicad_sch, single-sipm.kicad_sch]
2025-03-22 update layout and voltages
    [10sipm-for-angled.kicad_pcb, 10sipm-for-angled.kicad_sch, tia-2v5.kicad_sch, tia-m2v5.kicad_sch]
2025-06-02 Update files to V9
    [fc-board.kicad_pcb, fc-board.kicad_sch, flight-pcb-outline.kicad_pcb, gpio-hispeed.kicad_sch, gpio.kicad_sch, i2c-hub.kicad_sch, usb-hub.kicad_sch]
2025-06-02 Updates for new bubba board
    [AD5272BRMZ_20_RL7.stp, AD5292BRUZ_100_RL7.stp, BNX022-01L.stp, DTDG14GPT100.stp, ISL22317WFRTZ.stp, KMB22S.stp, LT3013MPFE_PBF.stp, MAX44243ASD+.stp]
2025-06-05 Added I2C and changed connectors
    [ADUM1253ASA.stp, bias-supply.kicad_pcb, bias-supply.kicad_sch, linear-regulator.kicad_sch, rectifier.kicad_sch]
2025-06-06 Touch ups to labels and added model for Harwin connector
    [M80_5000442.stp, bias-supply-backup.kicad_pcb, bias-supply.kicad_pcb, bias-supply.kicad_sch, bubba-oscillator.kicad_sch, gnd-stitching.kicad_sch, linear-regulator.kicad_sch, power-amp.kicad_sch]
2025-06-12 Board sent for printing
    [bias-supply-B_Cu.gbl, bias-supply-B_Mask.gbs, bias-supply-B_Paste.gbp, bias-supply-B_Silkscreen.gbo, bias-supply-Edge_Cuts.gm1, bias-supply-F_Cu.gtl, bias-supply-F_Mask.gts, bias-supply-F_Paste.gtp]
2025-06-12 Mezzanine (#4)
    * mezzanine: start schematics
    * wire up linear regulators for offset
    * start layout
    * laid out chunks and power
    * re-layout, better ground plane config
    * update layout: central D connector
    * remove planes under inputs/outputs of buffer
    * via stitching
    * update fabrication options
    [DGN0008D.stp, Download_STP_744253101_rev1.stp, MMCX-J-P-H-ST-EM1.step, TPS7A4901DGNT.step, mezzanine.kicad_pcb, mezzanine.kicad_sch, offset module.kicad_sch, vls4015cx-h.step]
2025-06-12 Updated notes
    [bias-supply.kicad_sch, bubba-oscillator.kicad_sch, gnd-stitching.kicad_sch, linear-regulator.kicad_sch, power-amp.kicad_sch, power-input-filtering.kicad_sch, rectifier.kicad_sch]
2025-06-26 LVPS from SwRI
    [AM5TW-2407D-RZ.step, BCS-110-L-D-TE.step, BCS-117-L-D-TE.step, CCG30-24-12S.step, CR_10S-M3I_VIS.step, DE2B3SA101KN3AY02F.step, GA342QR7GF101KW01L.step, IMPISH Power Supply.kicad_pcb]
2025-06-27 Removed zips; updated gitignore
    [fc-board.kicad_sch, gpio-hispeed.kicad_sch, gpio.kicad_sch, i2c-hub.kicad_sch, spi-hub.kicad_sch, usb-hub.kicad_sch]
2025-07-15 eMMC to microSD test board (#6)
    * eMMC test module thing
    * thickness and mounting holes
    [emmc-tester.kicad_pcb, emmc-tester.kicad_sch, emmc_100ball.step]
2025-09-01 Toggles board from SwRI
    [AP22804AW5-7.stp, BCS-105-L-D-TE.stp, BCS-110-L-D-TE.stp, IMPISH PS Toggles Board.kicad_pcb, IMPISH PS Toggles Board.kicad_sch, IMPISH Toggle Bd Sht 1.kicad_sch, IMPISH Toggle Bd Sht 2.kicad_sch, IMPISH Toggle Bd Sht2.kicad_sch]
2025-09-08 Power board updates (#7)
    * toggles adapter board
    The SwRI toggle output is in the wrong direction,
    so we are adding an additional PCB to point the power
    towards the side of the EPS box. We can route it with
    cables and connectors instead of using the board-to-board
    style interface.
    * toggles adapter: cleanup
    * toggles adapter: via stitching
    * swri toggles: start one ground
    * swri toggles: single ground pre stitching
    * swri toggles: via stitching for gnd
    * swri toggles: fix DRC and ERC errors
    * swri lvps main: two layer board
    * swri lvps main: fix cap models
    [IMPISH PS Toggles Board.kicad_pcb, IMPISH PS Toggles Board.kicad_sch, IMPISH Power Supply.kicad_pcb, IMPISH Toggle Bd Sht2.kicad_sch, IMPISH Toggle Bd Sht3.kicad_sch, IMPISH Toggle Bd Sht4.kicad_sch, IMPISH Toggle Bd Sht5.kicad_sch, MTSW-117-08-L-D-100.stp]
2025-09-15 Flat readout sipms (#8)
    * angled board is rectangular
    * rename sipm carrier project
    * updated per MSU comments
    * carrier OCD
    - coplanar waveguide with ground at almost exactly 50 ohm output from the buffer, leading into termination resistor
    - better ground return paths for the bias voltage
    [10sipm-for-angled.kicad_pcb, 10sipm-for-angled.kicad_sch, 732511150.stp, AFBR-S4N66P014M.stp, CONSMA020.062-G.step, CP-8-27_ADI.step, D0008A.stp, Download_STP_744253101_rev1.stp]
2025-09-17 swri: NC pin on toggle
    [IMPISH PS Toggles Board.kicad_pcb, IMPISH Toggle Bd Sht5.kicad_sch]
2025-10-10 FC board updates
    [74LVC1G07SE_7.stp, ADS122C04IPWR.stp, BCS-110-L-D-TE.stp, DSC1001CI2-025-0000T.stp, LAN7430T-I-Y9X.stp, LTC2983ILX-PBF.stp, M80-5002042.stp, M80_5000442.stp]
2025-10-16 sipms: 0.04mm gap
    [sipm-carrier.kicad_pcb]
2025-10-17 Finished routing; cleaned library
    [10067847-001RLF.stp, 1062.stp, 436500424.stp, 685119134923.stp, ADS1013BQDGSRQ1.stp, ADS1015BQDGSRQ1.stp, CR-1220-FCN.stp, ECS_3963_240_BN_TR.stp]
2025-10-18 Updated RJ45 jack
    [fc-board.kicad_sch, gpio-hispeed.kicad_sch, gpio.kicad_sch, i2c-hub.kicad_sch, pcie-ethernet.kicad_sch, spi-hub.kicad_sch]
2025-10-20 Assigned part numbers to everything, replaced ethernet jack
    [RJMG201K32630ER.stp, VLS3012HBX-3R3M.stp, fc-board.kicad_sch, gpio-hispeed.kicad_sch, gpio.kicad_sch, i2c-hub.kicad_sch, pcie-ethernet.kicad_sch, spi-hub.kicad_sch]
2025-10-27 Finalized layout
    [MTSW-104-13-L-D-1060.stp, MTSW-110-13-L-D-1060.stp, fc-board.kicad_sch, spi-hub.kicad_sch]
2025-10-31 V1 sent for printing
2025-11-19 Fc board (#9)
    * FC board updates
    * Finished routing; cleaned library
    * Updated RJ45 jack
    * Assigned part numbers to everything, replaced ethernet jack
    * Finalized layout
    * V1 sent for printing
    [10067847-001RLF.stp, 1062.stp, 436500424.stp, 685119134923.stp, 74LVC1G07SE_7.stp, ADS1013BQDGSRQ1.stp, ADS1015BQDGSRQ1.stp, ADS122C04IPWR.stp]
2025-12-11 Fixed incorrect routes, modified gondola eth, cosmetics
    [10103594-0001LF.stp, SM91509AL-E.stp, fc-board.kicad_sch, gpio-hispeed.kicad_sch, gpio.kicad_sch, i2c-hub.kicad_sch, pcie-ethernet.kicad_sch, spi-hub.kicad_sch]
2026-01-02 toggles
    remove cremat, fix layout, add DAQBOX toggle/power line
    [IMPISH PS Toggles Board.kicad_pcb, IMPISH PS Toggles Board.kicad_sch, IMPISH Toggle Bd Sht2.kicad_sch, IMPISH Toggle Bd Sht3.kicad_sch, IMPISH Toggle Bd Sht4.kicad_sch, IMPISH Toggle Bd Sht5.kicad_sch]
2026-01-06 Fixed PCIe routing, voltage sensing, added DAQ toggle, LCT interrupt, bias sensing resistors, SD card, and more
    [fc-board.kicad_sch, gpio.kicad_sch, i2c-hub.kicad_sch, pcie-ethernet.kicad_sch, spi-hub.kicad_sch]
2026-01-07 Updated footprints after core kicad changes
2026-01-07 Properly placed the Harwin connectors according to key
    [fc-board.kicad_sch, gpio.kicad_sch]
2026-01-07 toggles pcb: 4 layers
    [IMPISH PS Toggles Board.kicad_pcb]
2026-01-07 sipm board pre-production
    - verify spcaing between SiPMs
    - move silkscreens around so that they are not overlapping
    - change footprints to be hand-solder type in case someone has to do that
    - change values of some components to unify part list (e.g. any 100n are now 0.1u)
    [driven-tia.kicad_sch, single-sipm.kicad_sch, sipm-bias-filter.kicad_sch, sipm-carrier.kicad_pcb, sipm-carrier.kicad_sch, tia-m2v5.kicad_sch]
2026-01-08 Fleshed out part numbers and design rules
    [fc-board.kicad_sch, gpio-hispeed.kicad_sch, gpio.kicad_sch, i2c-hub.kicad_sch, pcie-ethernet.kicad_sch, spi-hub.kicad_sch]
2026-01-21 update main PSU: soldermask near edge
    [IMPISH Power Supply.kicad_pcb]
2026-01-22 junction board updates
    . add daqbox lines
    . fix heater routing
    . remove unused toggle lines
    . swap to nicer/cheaper/smaller 4-pin Molex for bias/preamp
    [5031750400.stp, lvps-toggles-adapter.kicad_pcb, lvps-toggles-adapter.kicad_sch]
2026-01-29 AdvancedPCB specs met
    [fc-board.kicad_sch, gpio-hispeed.kicad_sch, gpio.kicad_sch, i2c-hub.kicad_sch, pcie-ethernet.kicad_sch, spi-hub.kicad_sch]
2026-01-31 clean up tracks/vias
    [IMPISH PS Toggles Board.kicad_pcb]
2026-02-28 Add fuses; change to coax; fixed I2C gnd
    [F0603G0R02FNTR.stp, bias-supply.kicad_pcb, bias-supply.kicad_sch, bubba-oscillator.kicad_sch, gnd-stitching.kicad_sch, linear-regulator.kicad_sch, power-amp.kicad_sch, power-input-filtering.kicad_sch]
2026-03-06 Bubba V2.1
    [bias-supply-B_Cu.gbl, bias-supply-B_Mask.gbs, bias-supply-B_Paste.gbp, bias-supply-B_Silkscreen.gbo, bias-supply-Edge_Cuts.gm1, bias-supply-F_Cu.gtl, bias-supply-F_Mask.gts, bias-supply-F_Paste.gtp]
2026-04-08 kicad 10
    [IMPISH Power Supply.kicad_pcb]
