umn-impish/kicad/(notices)

Notices in the files:
lvps-toggles-swri/3D Models/MTSW-117-12-L-D-840.stp:
author */ ('License CC BY-ND 4.0'),
parts and their libraries:
Copyright 2016 Accelerated Designs. All rights reserved.
